individual61/r2-dtf/PCB/r2dtf dev board rev 1/Screenshot 2024-01-02 231258.png

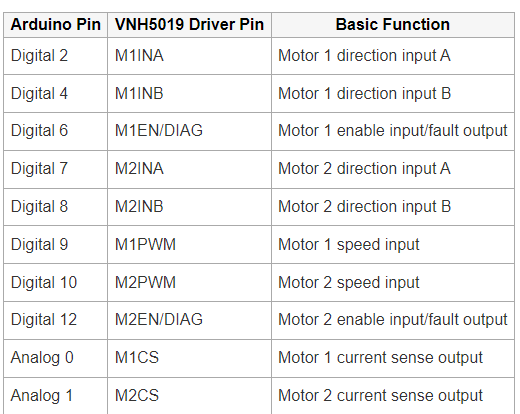
PCB/r2dtf dev board rev 1/Screenshot 2024-01-02 231258.png
