individual61/r2-dtf/Mechanicals/Sources for models/MPU 6050 IMU.SLDASM

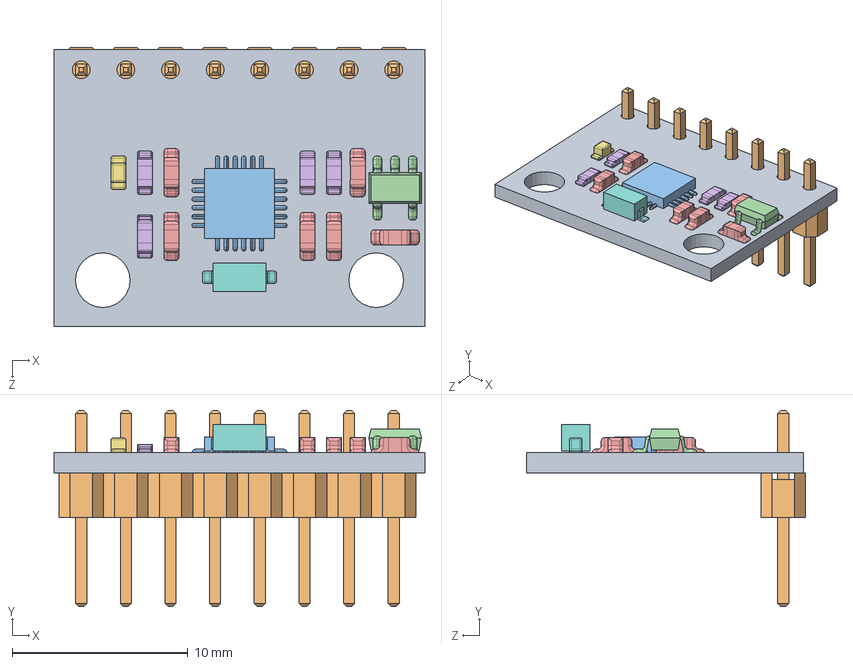
[picture p5: CAD file, 2018-06-27]
Mechanicals/Sources for models/MPU 6050 IMU.SLDASM
21.1 x 11.2 x 15.9 mm
Base
pin header x 8
sensor chip
S2NH chip
Resistor small x 6
Resistor small black x 4
Small LED
Resistor black
