individual61/r2-dtf/Mechanicals/Motor-bracket-wheel.SLDASM

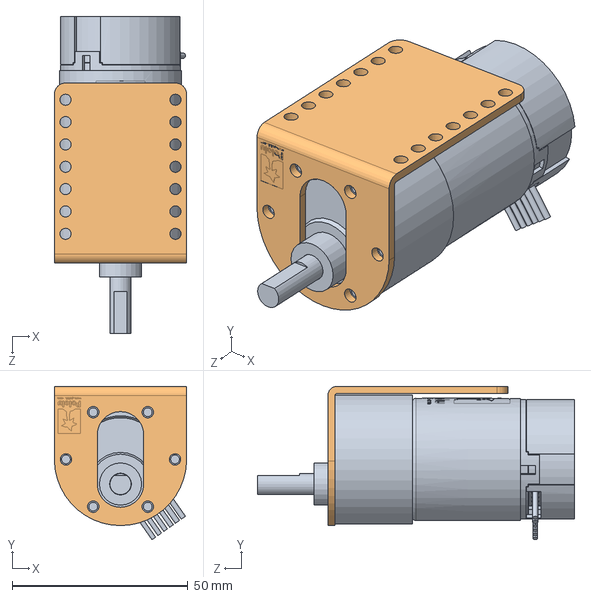
[picture p6: CAD file, 2025-01-21]
Mechanicals/Motor-bracket-wheel.SLDASM
37.6 x 43.6 x 90.1 mm
37d-gearmotor-19-30-encoder
pololu-stamped-aluminum-l-bracket-for-37d-mm-metal-gearmotors
