individual61/r2-dtf/Mechanicals/gy-521/User Library-GY-521.SLDASM

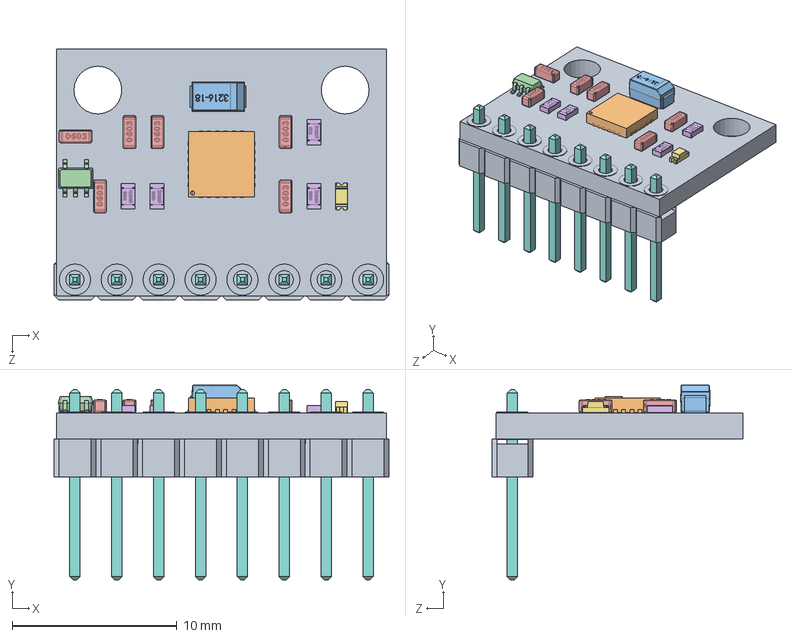
[picture p7: CAD file, 2024-02-24]
Mechanicals/gy-521/User Library-GY-521.SLDASM
20.3 x 11.8 x 15.2 mm
User Library-GY-521_placa
User Library-GY-521_User Library-mpu-6050_qfn-24
User Library-GY-521_User Library-CAP_TANT_3216-18_A_case-1
User Library-GY-521_User Library-sot353
User Library-GY-521_User Library-0603(1608M) Cap x 6
User Library-GY-521_User Library-RESC1608X05N x 4
User Library-GY-521_User Library-LED SMD0603
User Library-GY-521_User Library-Header_Male_8Pin_PinArray
User Library-GY-521_User Library-Header_Male_8Pin_BodyArray
