individual61/r2-dtf/Mechanicals/R2-DTF main assembly.SLDASM

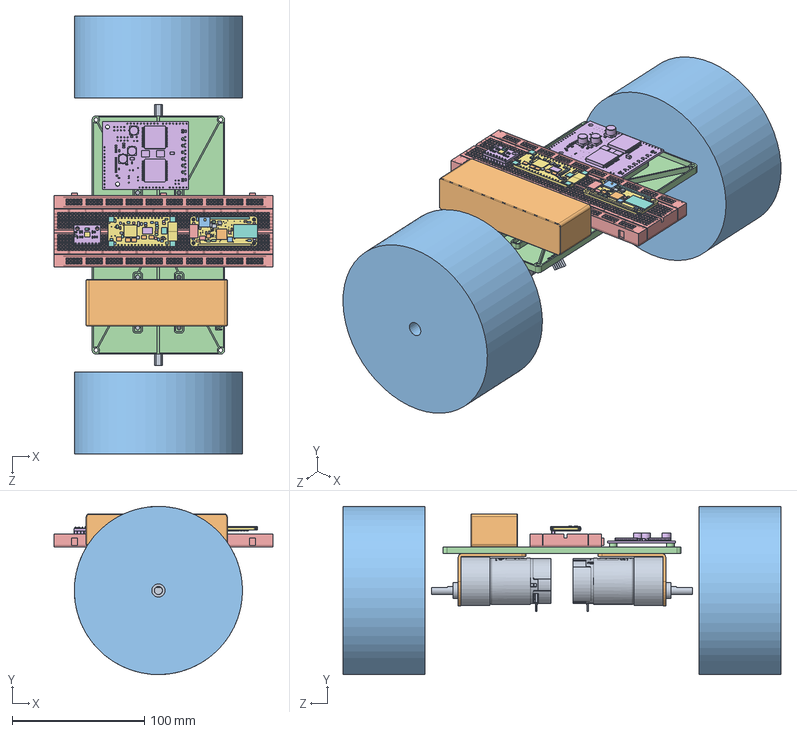
[picture p8: CAD file, 2018-06-27]
Mechanicals/R2-DTF main assembly.SLDASM
165.0 x 126.9 x 330.7 mm
37d-gearmotor-19-30-encoder x 2
pololu-stamped-aluminum-l-bracket-for-37d-mm-metal-gearmotors x 2
bigass wheel x 2
base REV A
BREADBOARD 60 ROW color
pololu-dual-vnh5019-motor-driver-shield
adafruit feather zero ble rev a
Capacitor 0603 x 5
Capacitor 0805 x 5
CHIPLED_0805_NOOUTLINE_ORANGE
SOD 123 x 3
CHIPLED_0805_NOOUTLINE_RED x 3
CHIPLED_0805_NOOUTLINE_BLUE
1X16_ROUND_JP1_1X16_ROUND
1X12_ROUND_JP3_1X12_ROUND
0603NO_100K x 3
0603NO_1K
0603NO_2_2K x 3
0603NO_10K_
KMR2_SPST_TACTKMR2
TESTPOINT_ROUND_1_5MM_TP1_TESTPOINT_ROUND_1_5MM
TESTPOINT_ROUND_1_5MM_TP2_TESTPOINT_ROUND_1_5MM
PAD1_5X2_0_SWCLK
PAD1_5X2_0_SWDIO x 2
TQFN48_7MM_ATSAMD21G18_QFN
ADAFRUIT_3_5MM_U_7_ADAFRUIT_3_5MM
FEATHERLOGO_U_9_FEATHERLOGO
PCBFEATREV040_U_25_PCBFEATREV040
BLUEFRUITLOGO_100MM_U_26_BLUEFRUITLOGO_100MM
FIDUCIAL_1MM_FIDUCIAL__ x 4
BLE_MODULE_RAYTAC_MDBT40_MBT40
SOT235_AP21123_3
SOT235_MCP73831T2ACI_OT
JSTPH2_JSTPH x 2
XTAL3215_32_768
4UCONN_20329_V2_MICROUSB
User Library-GY-521_placa
User Library-GY-521_User Library-mpu-6050_qfn-24
User Library-GY-521_User Library-CAP_TANT_3216-18_A_case-1
User Library-GY-521_User Library-sot353
User Library-GY-521_User Library-0603(1608M) Cap x 6
User Library-GY-521_User Library-RESC1608X05N x 4
User Library-GY-521_User Library-LED SMD0603
User Library-GY-521_User Library-Header_Male_8Pin_PinArray
User Library-GY-521_User Library-Header_Male_8Pin_BodyArray
adafruit ezsfx with amp
0805_10MGAP_10UF x 3
0805NO_1UF x 2
0805NO_0_1_F x 3
0805NO_4_7NF x 2
0805NO_1_F x 2
SOD323_1N4148
_0805MP_FERRITE x 2
TERMBLOCK_1X23_5MM_3_5MM x 2
CHIPLED_0805_NOOUTLINE_GREEN
0805NO_1M
RESPACK_4X0603_100K x 5
0805NO_470 x 4
0805NO_100K x 2
SOLDERJUMPER_ARROW_NOPASTE_SJ1_SOLDERJUMPER_ARROW_NOPASTE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
