individual61/r2-dtf/Mechanicals/gy-521/User Library-GY-521_User Library-mpu-6050_qfn-24.SLDPRT

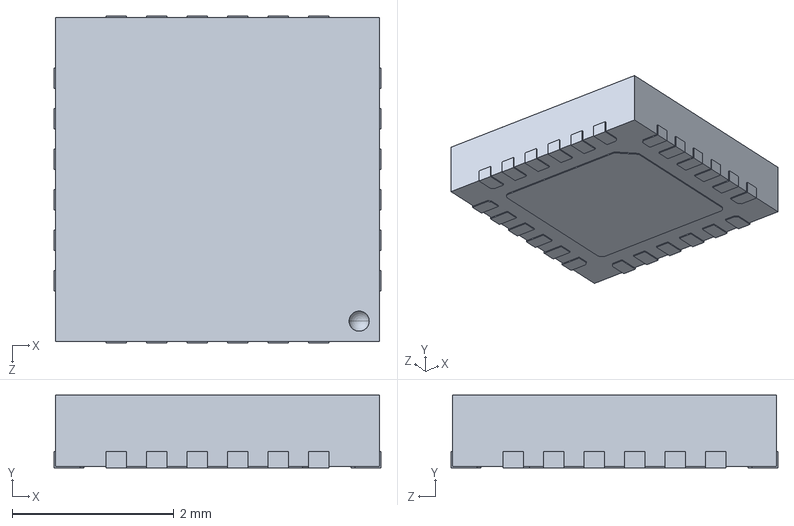
[picture p9: CAD file, 2024-02-24]
Mechanicals/gy-521/User Library-GY-521_User Library-mpu-6050_qfn-24.SLDPRT
4.04 x 0.9 x 4.04 mm
