individual61/r2-dtf/Mechanicals/Sources for models/BREADBOARD 60ROW/BREADBOARD 60 ROW.SLDPRT

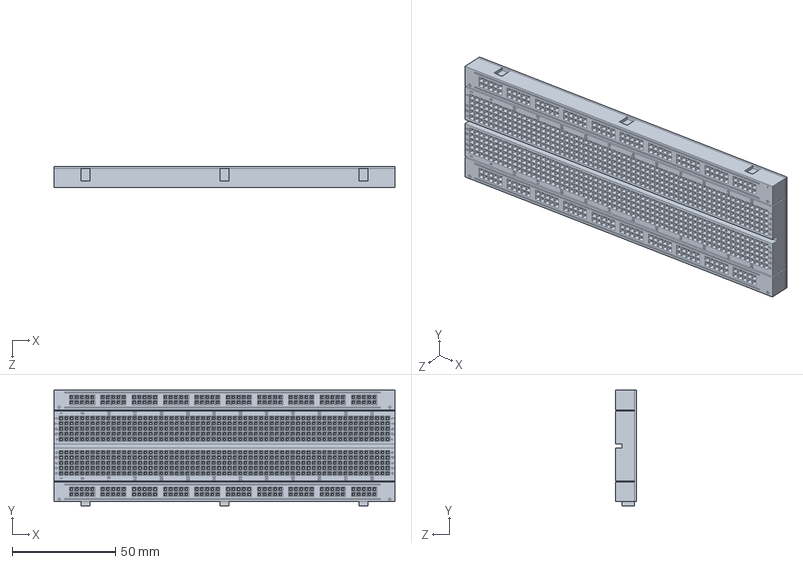
[picture p10: CAD file, 2018-06-27]
Mechanicals/Sources for models/BREADBOARD 60ROW/BREADBOARD 60 ROW.SLDPRT
165.0 x 56.0 x 10.0 mm
