individual61/r2-dtf/Mechanicals/Test Stand Rev 1.STEP

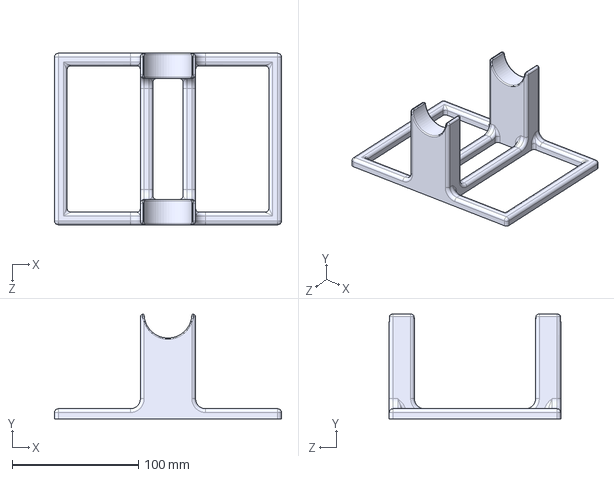
[picture p11: CAD file, 2025-01-21]
Mechanicals/Test Stand Rev 1.STEP
180.0 x 83.0 x 136.0 mm
