individual61/r2-dtf/Mechanicals/gy-521/User Library-GY-521_User Library-CAP_TANT_3216-18_A_case-1.SLDPRT

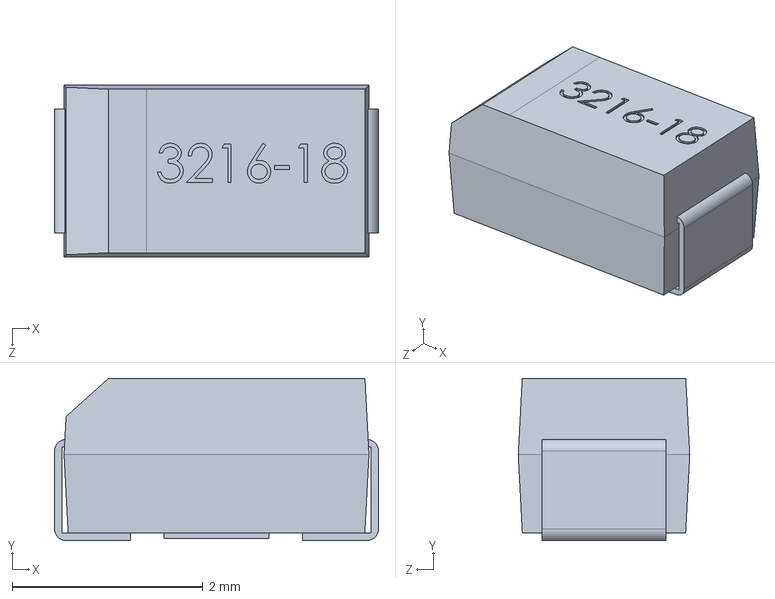
[picture p12: CAD file, 2024-02-24]
Mechanicals/gy-521/User Library-GY-521_User Library-CAP_TANT_3216-18_A_case-1.SLDPRT
3.40 x 1.70 x 1.80 mm
