individual61/r2-dtf/Mechanicals/Sources for models/37d-gearmotor-19-30-encoder.step

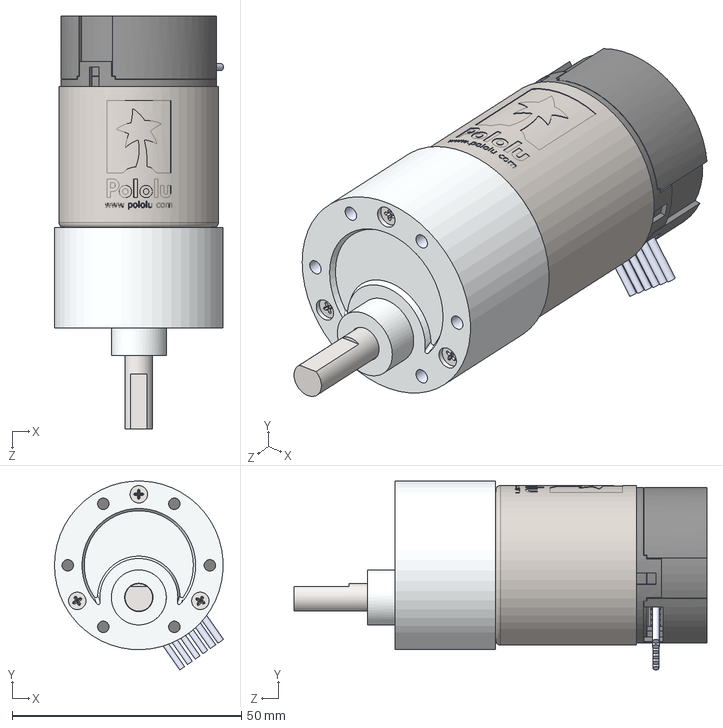
[picture p13: CAD file, 2018-06-27]
Mechanicals/Sources for models/37d-gearmotor-19-30-encoder.step
36.9 x 41.2 x 90.1 mm
