individual61/r2-dtf/Mechanicals/Sources for models/pololu-universal-aluminum-mounting-hub-for-6mm-shaft-4-40-holes.step

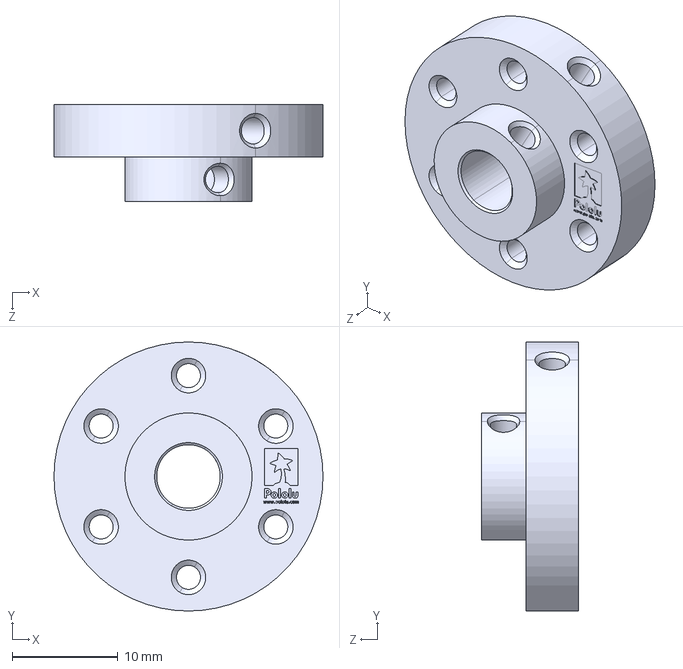
[picture p14: CAD file, 2018-06-27]
Mechanicals/Sources for models/pololu-universal-aluminum-mounting-hub-for-6mm-shaft-4-40-holes.step
25.4 x 25.4 x 9.20 mm
