individual61/r2-dtf/Mechanicals/Frame Rev 1.STEP

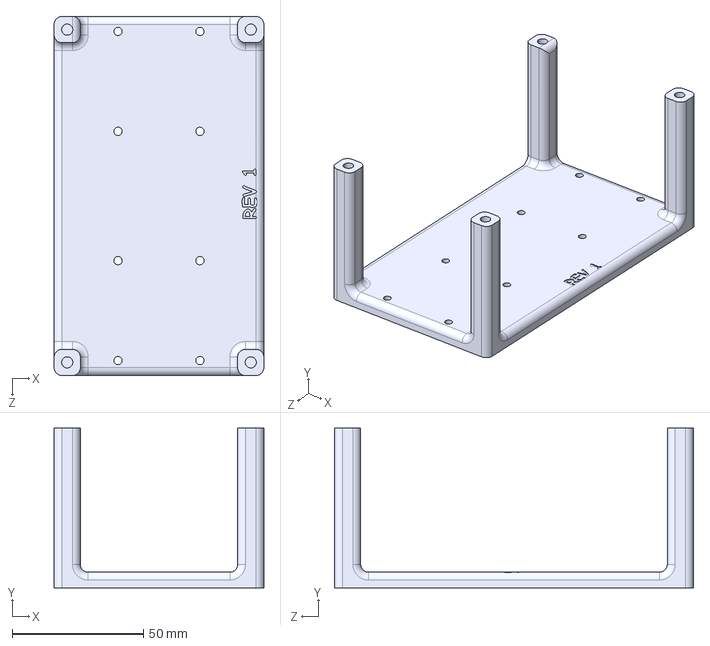
[picture p15: CAD file, 2024-02-27]
Mechanicals/Frame Rev 1.STEP
80.0 x 61.0 x 136.9 mm
