individual61/r2-dtf/Mechanicals/Sources for models/pololu-stamped-aluminum-l-bracket-for-37d-mm-metal-gearmotors.step

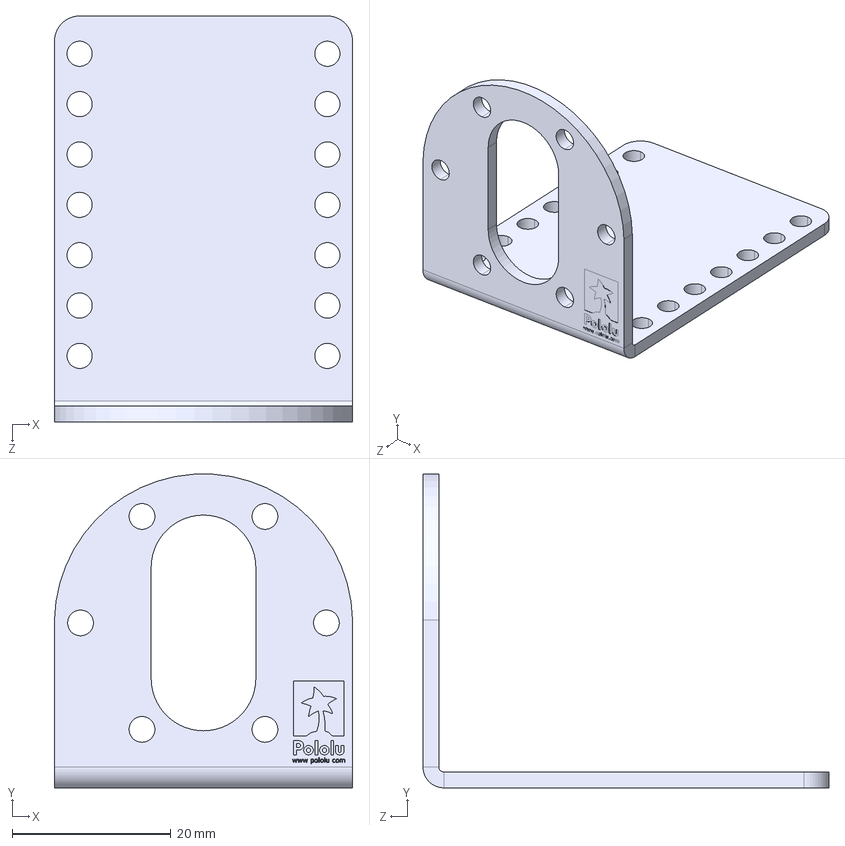
[picture p16: CAD file, 2018-06-27]
Mechanicals/Sources for models/pololu-stamped-aluminum-l-bracket-for-37d-mm-metal-gearmotors.step
37.6 x 39.6 x 51.2 mm
