individual61/r2-dtf/Mechanicals/gy-521/User Library-GY-521_User Library-RESC1608X05N.SLDPRT

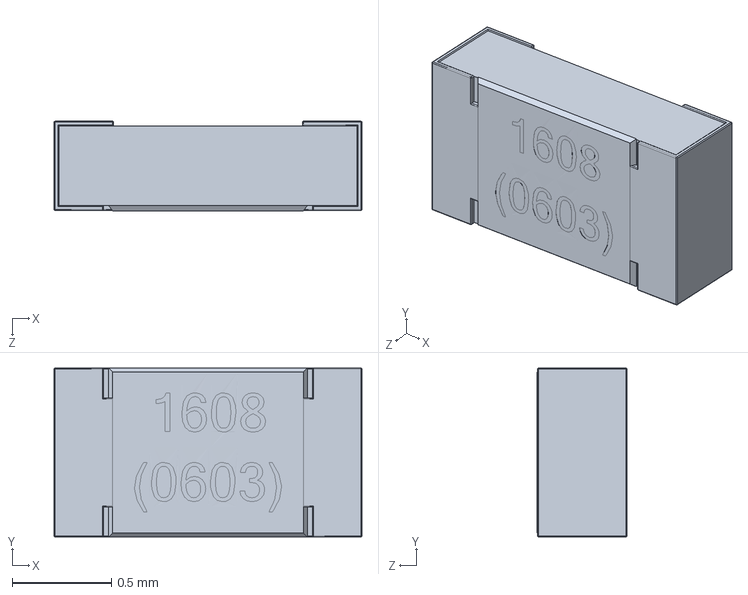
[picture p17: CAD file, 2024-02-24]
Mechanicals/gy-521/User Library-GY-521_User Library-RESC1608X05N.SLDPRT
1.55 x 0.85 x 0.451 mm
