individual61/r2-dtf/Mechanicals/M3 x 16 - actually 15.7.SLDPRT

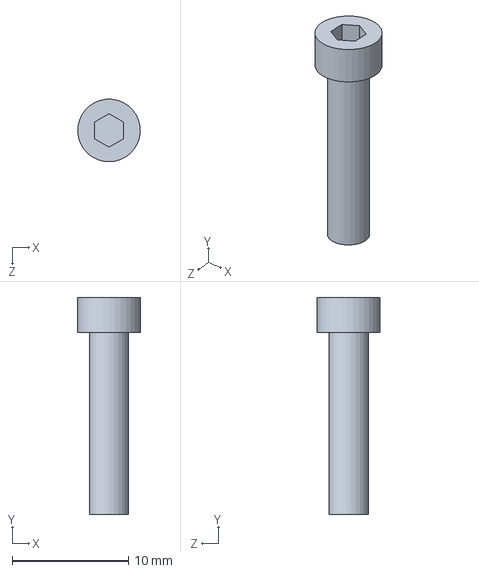
[picture p18: CAD file, 2024-02-27]
Mechanicals/M3 x 16 - actually 15.7.SLDPRT
5.39 x 18.7 x 5.39 mm
