individual61/r2-dtf/Mechanicals/gy-521/User Library-GY-521_User Library-0603(1608M) Cap.SLDPRT

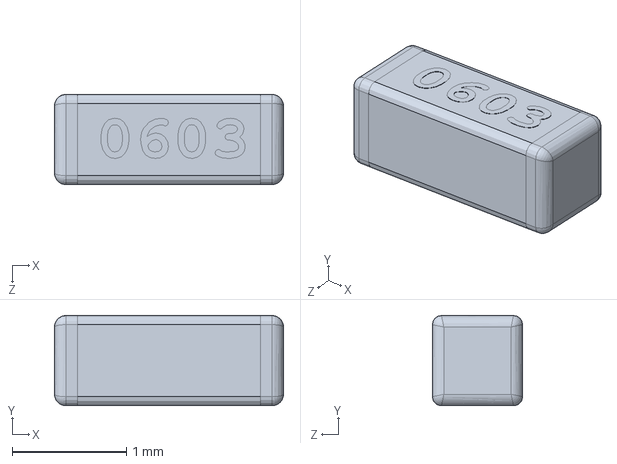
[picture p19: CAD file, 2024-02-24]
Mechanicals/gy-521/User Library-GY-521_User Library-0603(1608M) Cap.SLDPRT
2.00 x 0.79 x 0.787 mm
