individual61/r2-dtf/Mechanicals/M3 x 8 - actually 7.8.SLDPRT

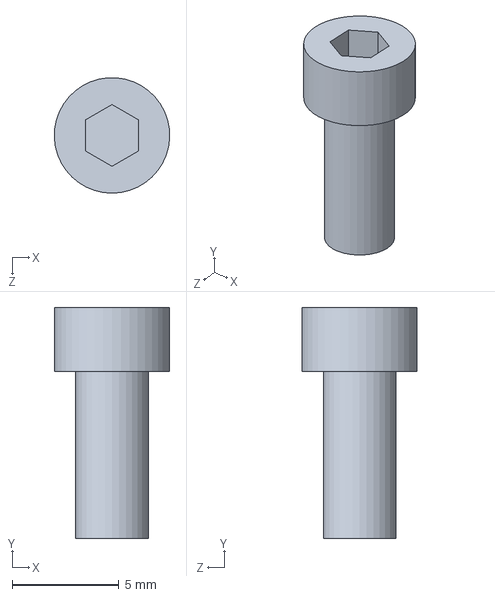
[picture p20: CAD file, 2024-02-27]
Mechanicals/M3 x 8 - actually 7.8.SLDPRT
5.40 x 10.8 x 5.39 mm
