individual61/r2-dtf/Mechanicals/Bumper Rev 1.STEP

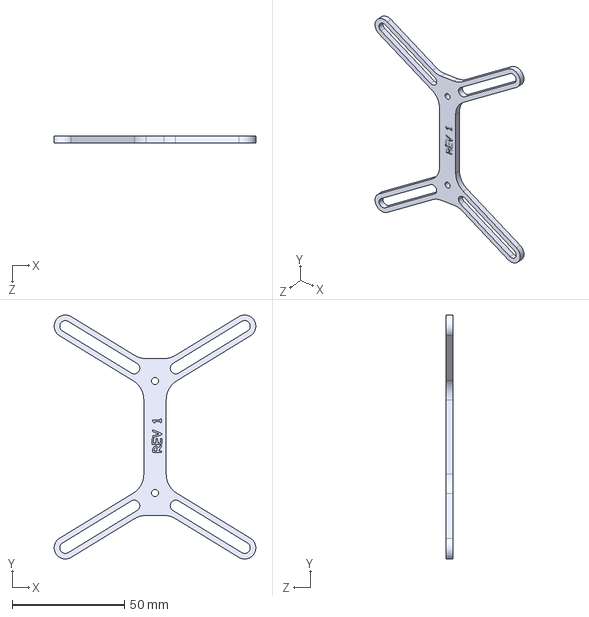
[picture p21: CAD file, 2024-02-27]
Mechanicals/Bumper Rev 1.STEP
90.0 x 108.9 x 3.00 mm
