individual61/r2-dtf/Mechanicals/gy-521/User Library-GY-521_User Library-LED SMD0603.SLDPRT

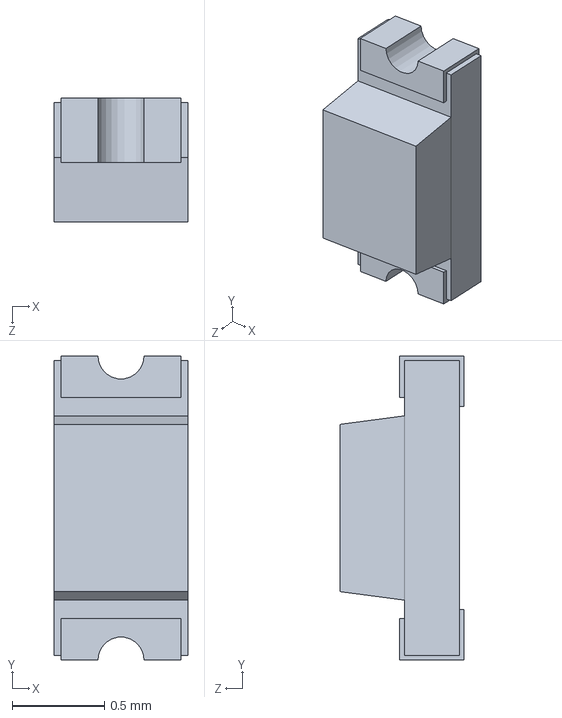
[picture p22: CAD file, 2024-02-24]
Mechanicals/gy-521/User Library-GY-521_User Library-LED SMD0603.SLDPRT
0.725 x 1.65 x 0.675 mm
