individual61/r2-dtf/Mechanicals/Frame top Rev 1.STEP

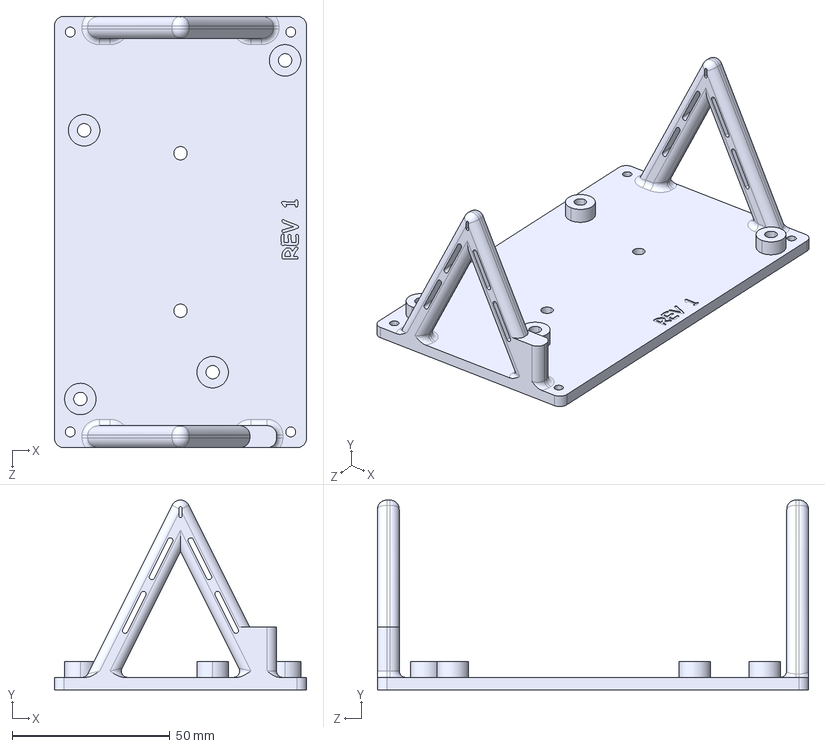
[picture p23: CAD file, 2024-02-27]
Mechanicals/Frame top Rev 1.STEP
80.0 x 60.3 x 136.9 mm
