individual61/r2-dtf/Mechanicals/gy-521/User Library-GY-521_User Library-sot353.SLDPRT

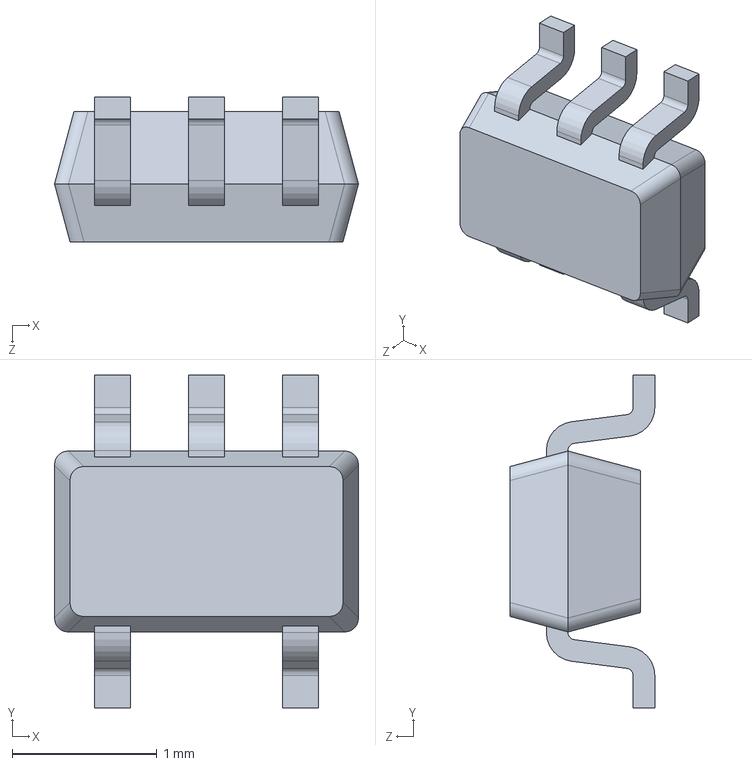
[picture p24: CAD file, 2024-02-24]
Mechanicals/gy-521/User Library-GY-521_User Library-sot353.SLDPRT
2.10 x 2.30 x 1.00 mm
