individual61/r2-dtf/Mechanicals/gy-521/User Library-GY-521_placa.SLDPRT

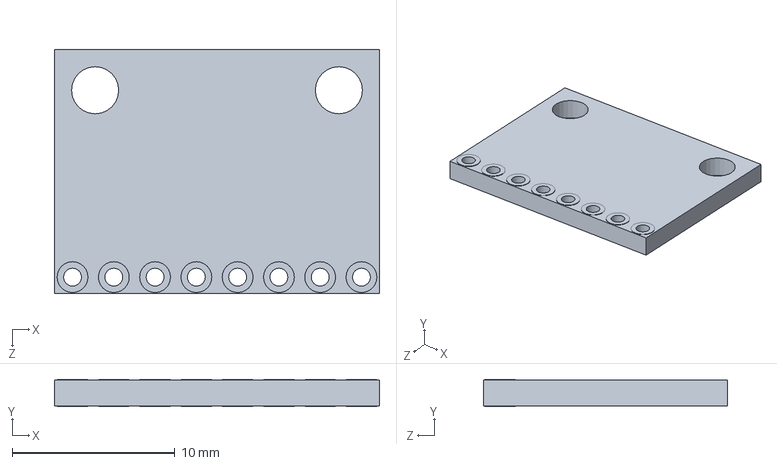
[picture p25: CAD file, 2024-02-24]
Mechanicals/gy-521/User Library-GY-521_placa.SLDPRT
20.0 x 1.67 x 15.0 mm
