individual61/r2-dtf/Mechanicals/M3 x 6.SLDPRT

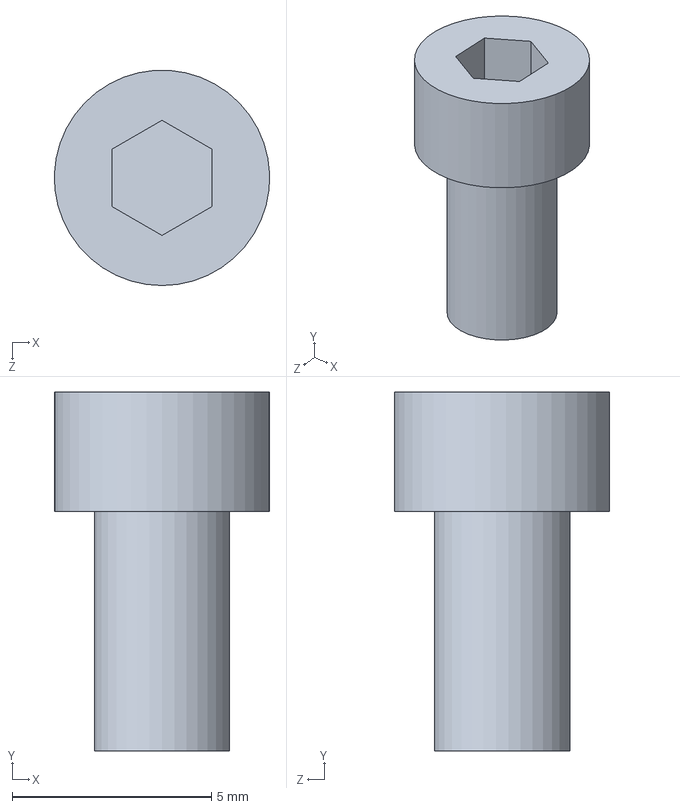
[picture p26: CAD file, 2024-02-27]
Mechanicals/M3 x 6.SLDPRT
5.40 x 9.00 x 5.39 mm
