individual61/r2-dtf/Mechanicals/pololu-wheel-90x10mm-yellow.step

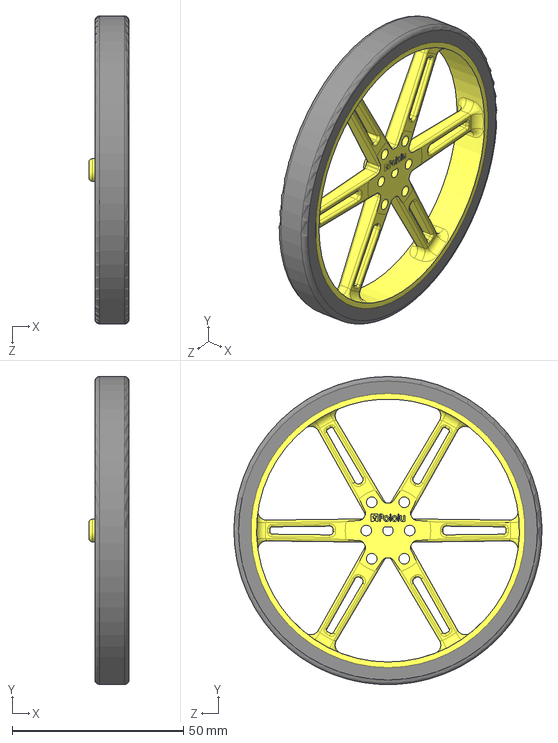
[picture p27: CAD file, 2024-02-24]
Mechanicals/pololu-wheel-90x10mm-yellow.step
11.8 x 90.0 x 90.0 mm
