individual61/r2-dtf/Mechanicals/base REV A.SLDPRT

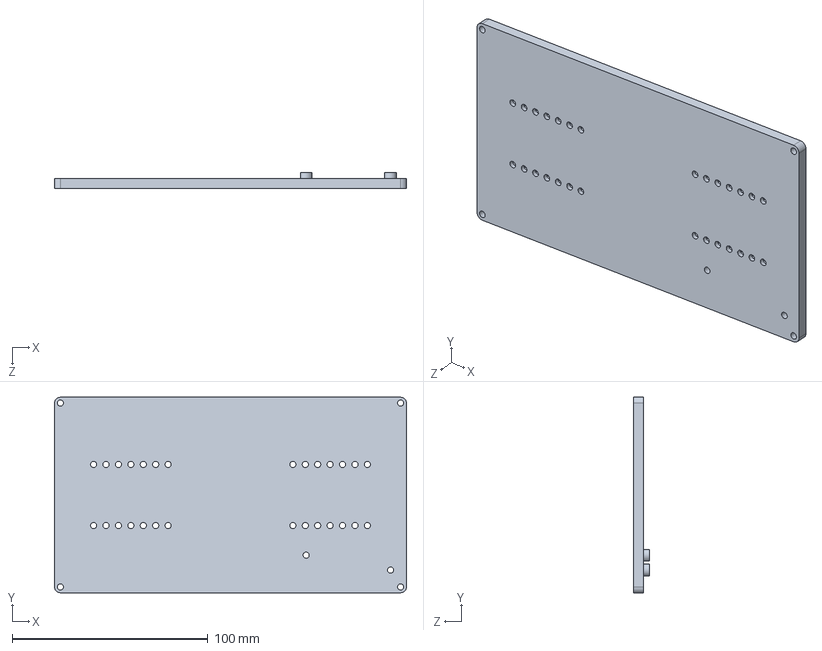
[picture p28: CAD file, 2024-02-24]
Mechanicals/base REV A.SLDPRT
180.0 x 100.0 x 8.00 mm
