individual61/r2-dtf/Mechanicals/pololu-dual-vnh5019-motor-driver-shield.SLDPRT

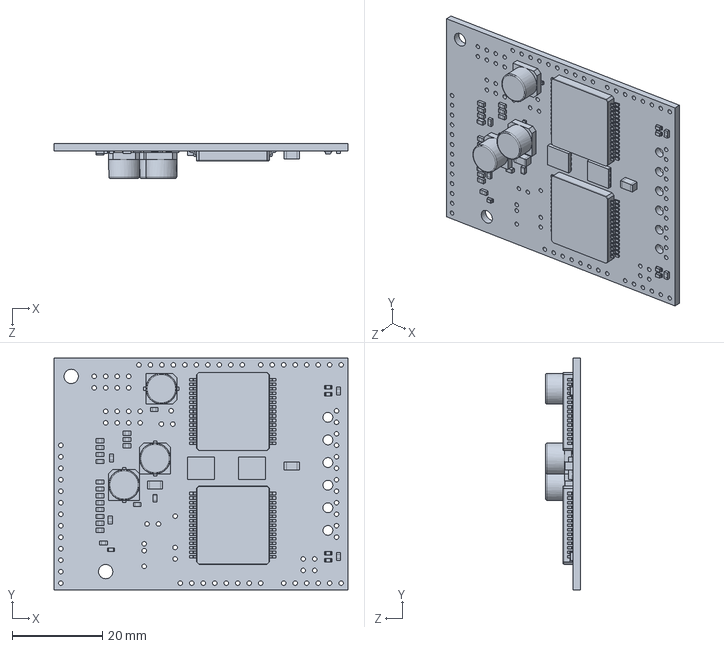
[picture p29: CAD file, 2024-02-24]
Mechanicals/pololu-dual-vnh5019-motor-driver-shield.SLDPRT
65.0 x 51.3 x 7.67 mm
