individual61/r2-dtf/Mechanicals/lipo 3s battery.SLDPRT

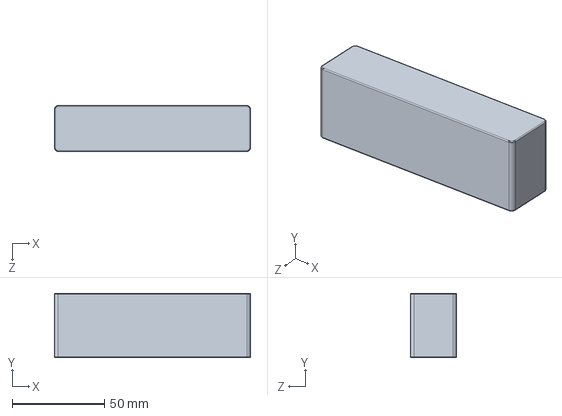
[picture p30: CAD file, 2024-02-24]
Mechanicals/lipo 3s battery.SLDPRT
106.5 x 35.0 x 25.0 mm
