individual61/r2-dtf/Mechanicals/bigass wheel.SLDPRT

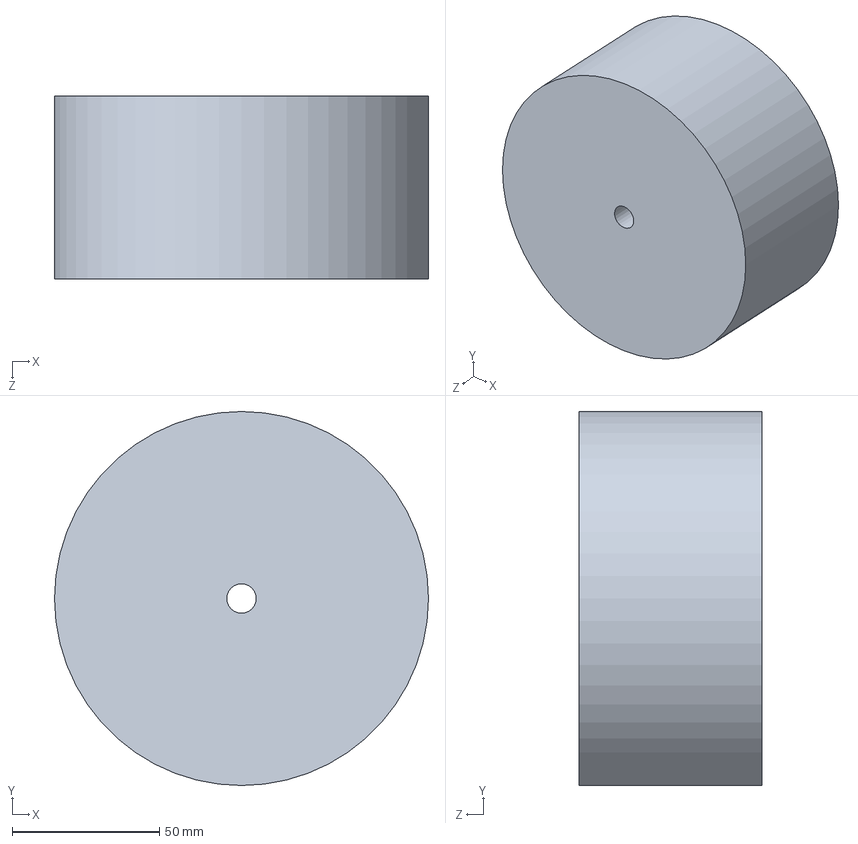
[picture p31: CAD file, 2024-02-24]
Mechanicals/bigass wheel.SLDPRT
127.0 x 127.0 x 62.0 mm
