individual61/r2-dtf/Mechanicals/speaker.SLDPRT

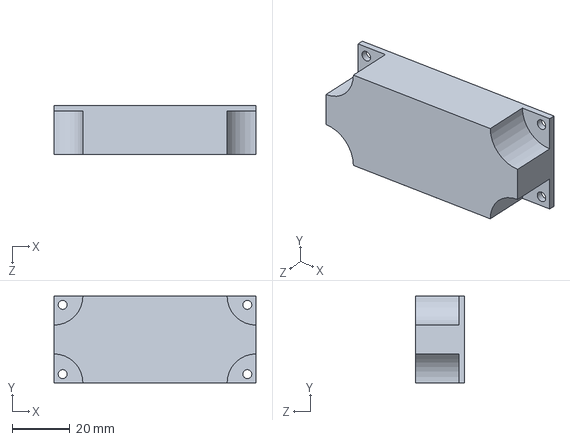
[picture p32: CAD file, 2018-06-27]
Mechanicals/speaker.SLDPRT
70.0 x 30.0 x 17.0 mm
