individual61/r2-dtf/Mechanicals/gy-521/User Library-GY-521_User Library-Header_Male_8Pin.sldasm

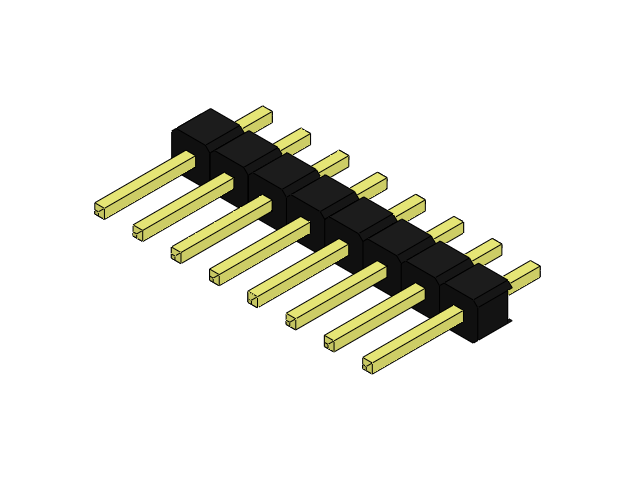
[picture p33: CAD file, 2024-02-24]
Mechanicals/gy-521/User Library-GY-521_User Library-Header_Male_8Pin.sldasm
User Library-GY-521_User Library-Header_Male_8Pin_PinArray
User Library-GY-521_User Library-Header_Male_8Pin_BodyArray
