individual61/r2-dtf/(list of files, cad)

Other CAD files:
Mechanicals/adafruit ezsfx with amp.SLDASM
Mechanicals/adafruit feather zero ble rev a.SLDASM
Mechanicals/gy-521/User Library-GY-521_User Library-Header_Male_8Pin_PinArray.sldprt
Mechanicals/M3 x 12 - actually 11.6.SLDPRT
Mechanicals/gy-521/User Library-GY-521_User Library-Header_Male_8Pin_BodyArray.sldprt
Mechanicals/37d-gearmotor-19-30-encoder.SLDPRT
Mechanicals/pololu-wheel-90x10mm-black.step
Mechanicals/pololu-stamped-aluminum-l-bracket-for-37d-mm-metal-gearmotors.SLDPRT
Mechanicals/pololu-wheel-90x10mm-white.step
Mechanicals/pololu-wheel-90x10mm-blue.step
Mechanicals/pololu-universal-aluminum-mounting-hub-for-6mm-shaft-4-40-holes.SLDPRT
Mechanicals/BREADBOARD 60 ROW color.SLDPRT
Mechanicals/pololu-wheel-90x10mm-red.step
Mechanicals/Bumper Rev 1.SLDPRT
Mechanicals/Frame Rev 1.3mf
Mechanicals/Frame Rev 1.SLDPRT
Mechanicals/Frame top Rev 1.SLDPRT
Mechanicals/M3 Nut.SLDPRT
Mechanicals/M3 Washer.SLDPRT
Mechanicals/Test Stand Rev 1.SLDPRT
Mechanicals/base REV A.STL
Mechanicals/base.SLDPRT
Mechanicals/pololu-wheel-90x10mm-red.SLDPRT
