individual61/r2-dtf/PCB/r2dtf dev board rev 1/r2dtf dev board rev 1.pdf

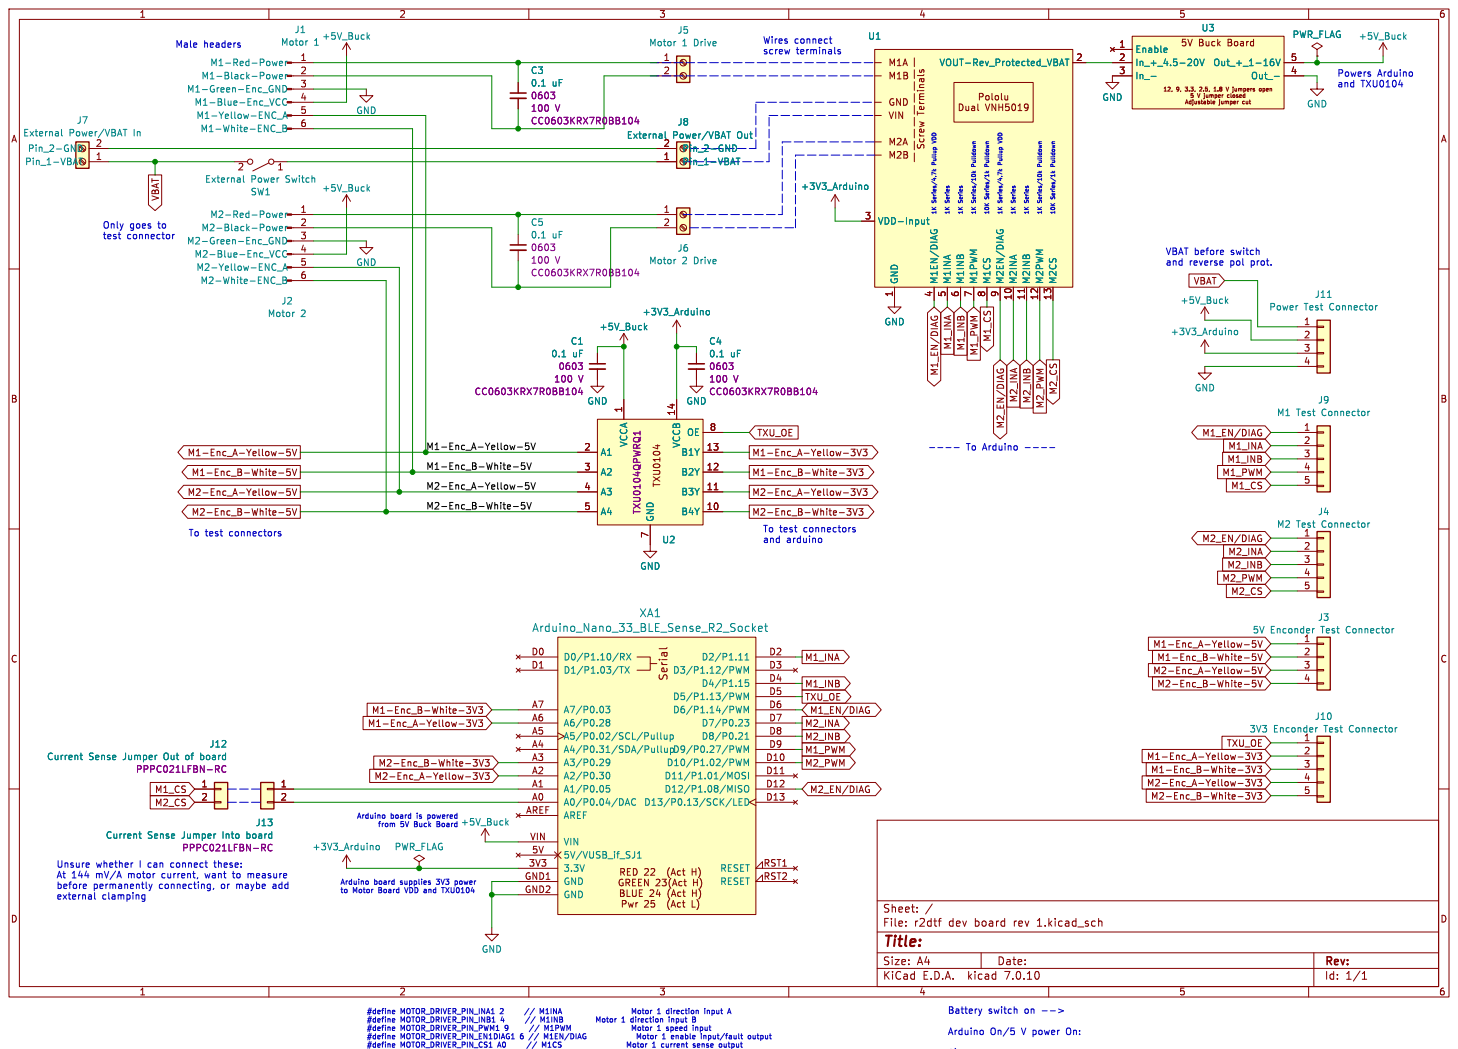
[picture p34: page 1]

9 U1 +5V_Buck 1
J6 Motor 2 Drive GND GND

1 M2INA 10 M2INB 11 M2PWM 12 M2CS 13 VOUT-Rev_Protected_VBAT 2 VDD-Input 3 M1EN/DIAG

and TXU0104 VBAT before switch

and reverse pol prot.
VBAT

J12 Current Sense Jumper Out of board PPPC021LFBN-RC

J13 Current Sense Jumper Into board PPPC021LFBN-RC

to Motor Board VDD and TXU0104 Female headers 2- pos: (2) Current Sense Jumper

Battery switch on --> Arduino On/5 V power On: 1) OE of TXU0104 is disabled Motor INXA/B are both low so CS output is 0. 2) OE is enabled, passing Hall sensor signals through
