individual61/r2-dtf/PCB/r2dtf dev board rev 1/Layout Rev 1 for print.pdf

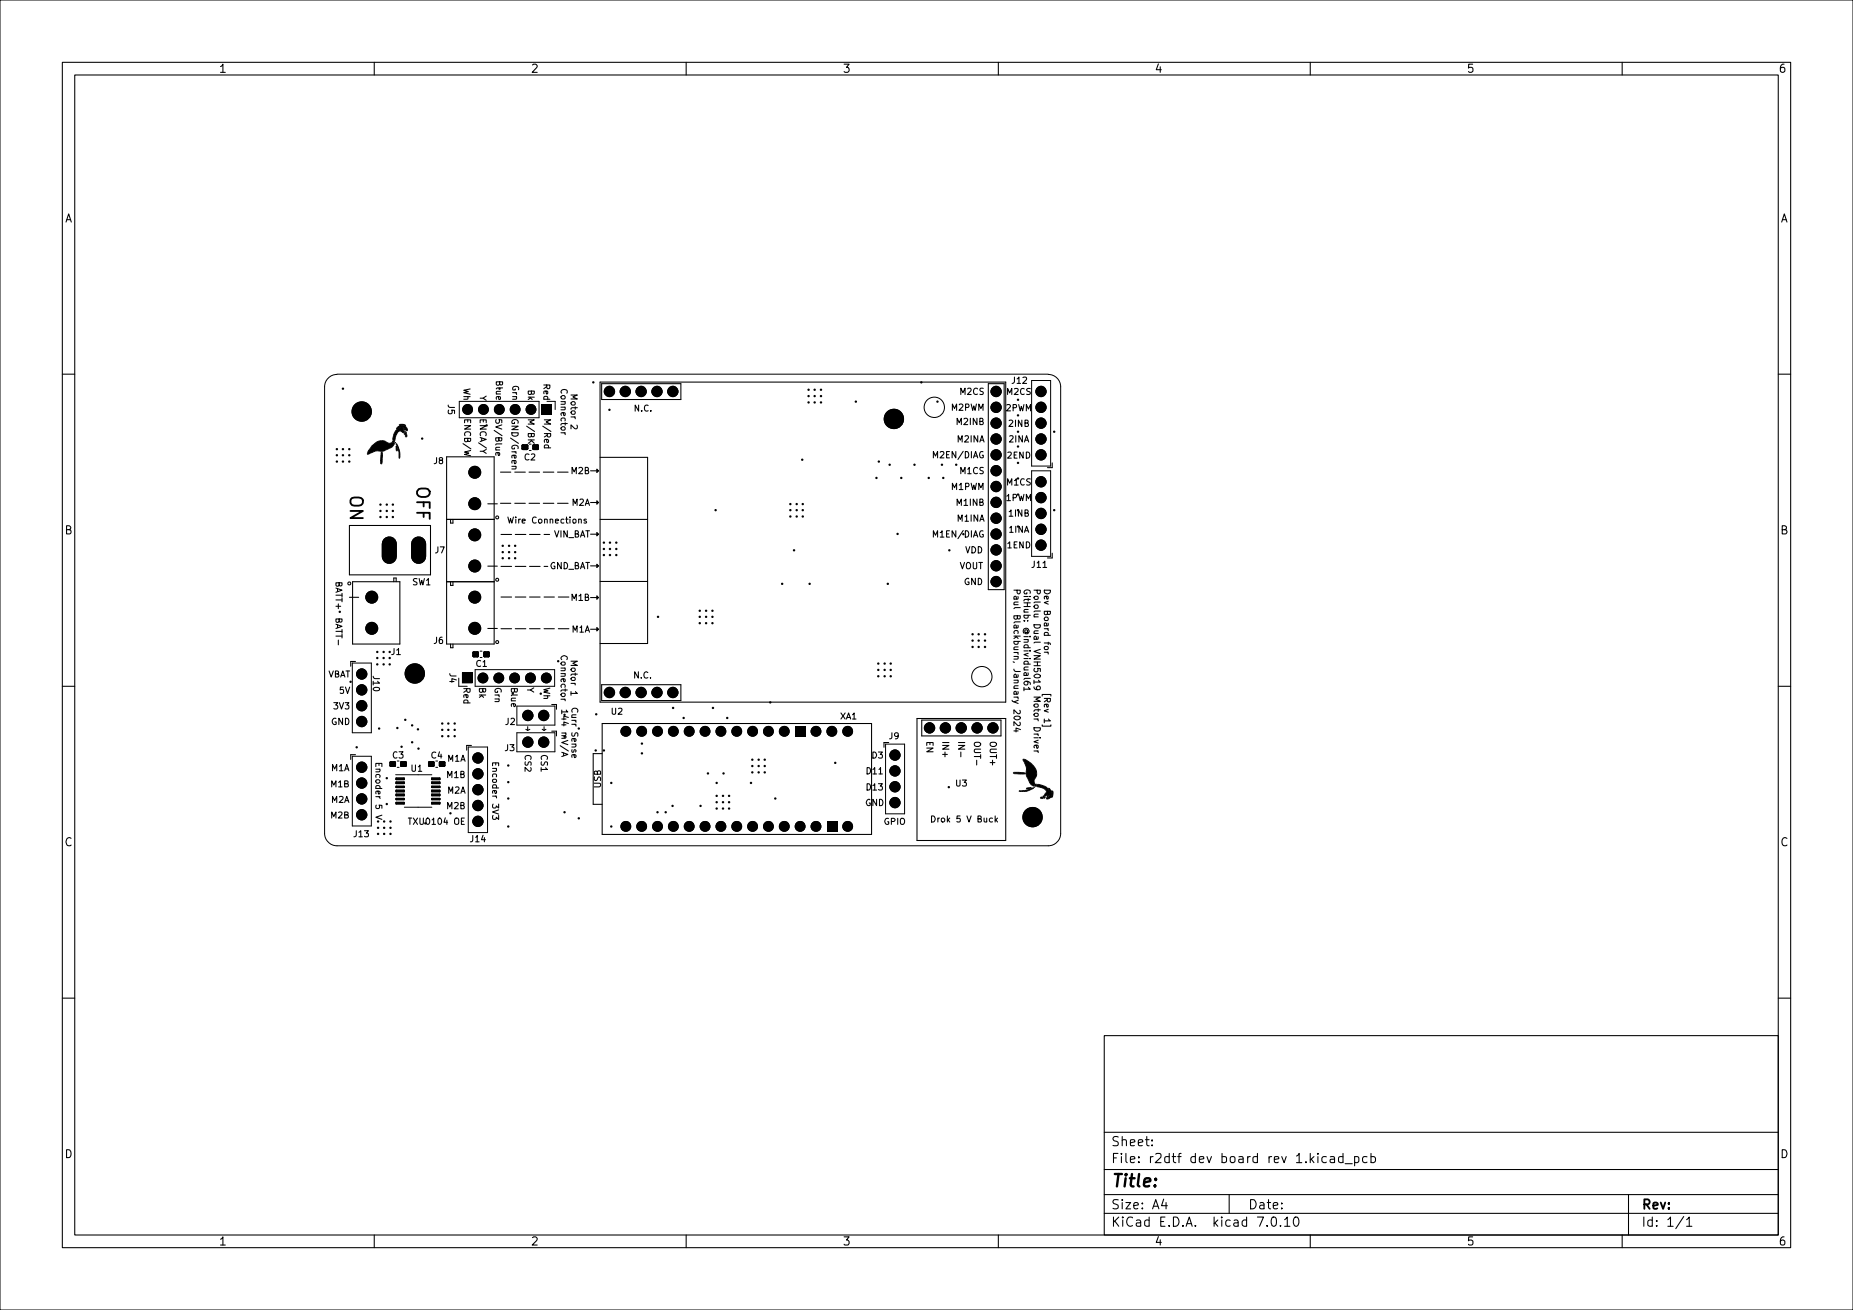
[picture p35: page 1]
