individual61/r2-dtf/PCB/r2dtf dev board rev 1/r2dtf dev board rev 1.kicad_pcb

## KiCad design PCB/r2dtf dev board rev 1/r2dtf dev board rev 1.kicad_pcb (2024-01-19)

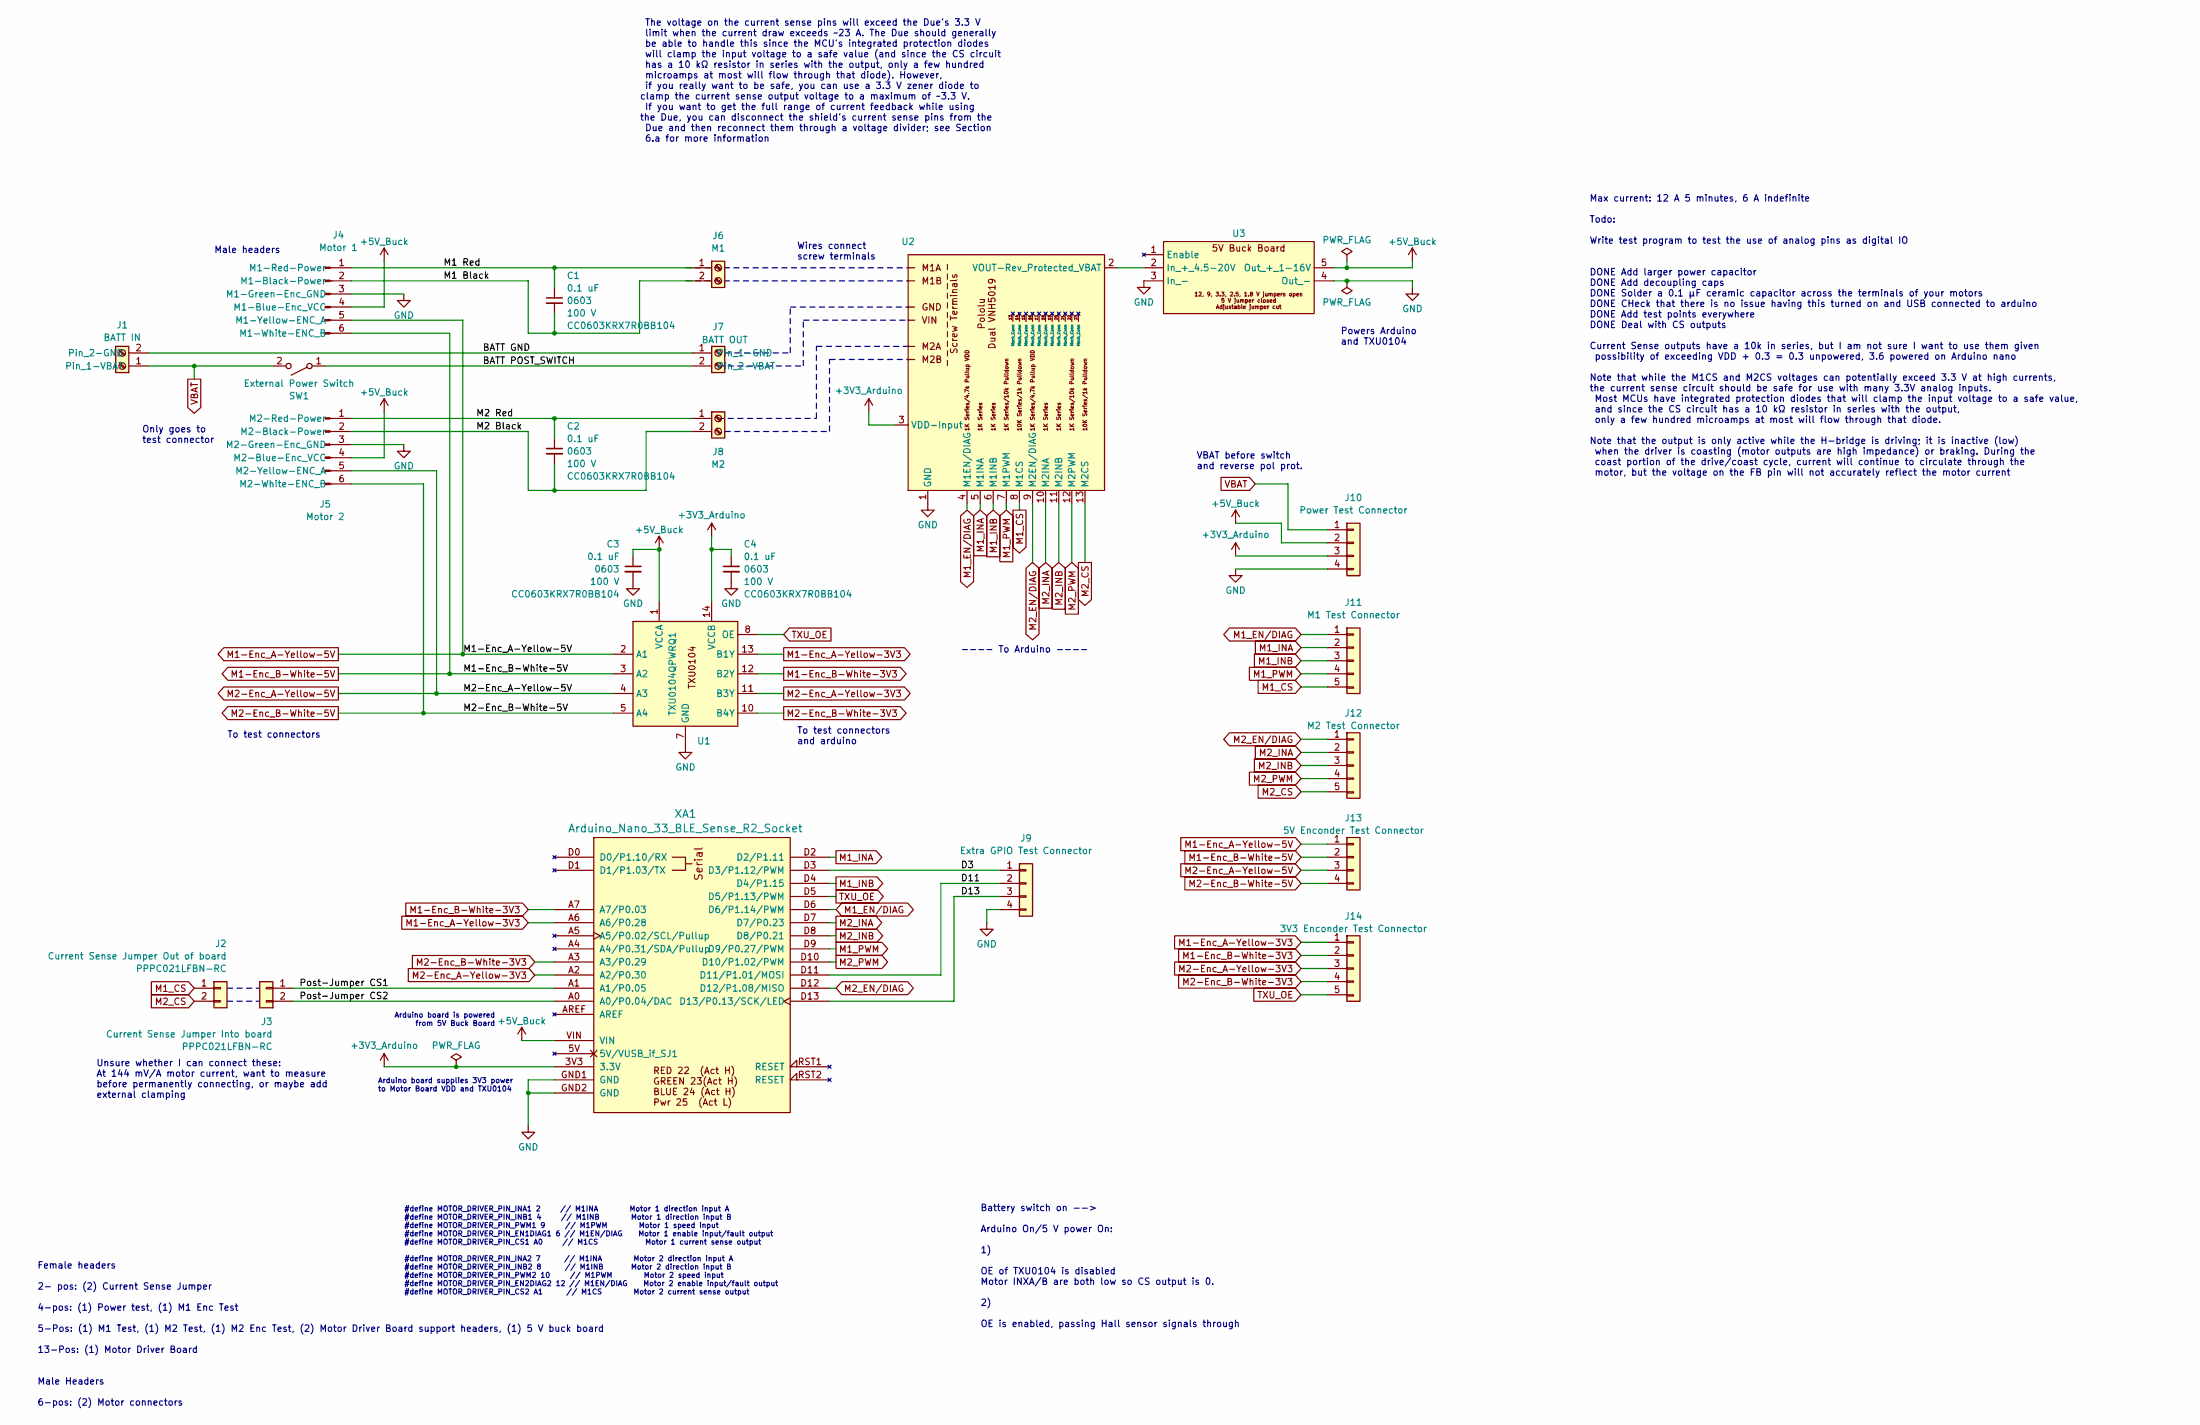
[picture p36: schematic r2dtf dev board rev 1.kicad_sch]

Parts:
C1, C2, C3, C4: 0.1 uF; C_0603_1608Metric_Pad1.08x0.95mm_HandSolder; Voltage Rating 100 V; MPN CC0603KRX7R0BB104; Digi-Key_PN 311-1523-1-ND
J1: BATT IN; Screw Terminal 2P 5 mm, Degson DG301-5.0-02P
J2: Current Sense Jumper Out of board; Sullins Header Female TH 2 x 1 PPPC021LFBN-RC; MPN PPPC021LFBN-RC
J3: Current Sense Jumper Into board; Sullins Header Female TH 2 x 1 PPPC021LFBN-RC; MPN PPPC021LFBN-RC
J4: Motor 1; PinHeader_1x06_P2.54mm_Vertical
J5: Motor 2; PinHeader_1x06_P2.54mm_Vertical
J6: M1; Screw Terminal 2P 5 mm, Degson DG301-5.0-02P
J7: BATT OUT; Screw Terminal 2P 5 mm, Degson DG301-5.0-02P
J8: M2; Screw Terminal 2P 5 mm, Degson DG301-5.0-02P
J9: Extra GPIO Test Connector; Sullins Header Female TH 4 x 1 PPPC041LFBN-RC; MPN PPPC041LFBN-RC
J10: Power Test Connector; Sullins Header Female TH 4 x 1 PPPC041LFBN-RC; MPN PPPC041LFBN-RC
J11: M1 Test Connector; Sullins Header Female TH 5 x 1 PPPC051LFBN-RC; MPN PPPC051LFBN-RC
J12: M2 Test Connector; Sullins Header Female TH 5 x 1 PPPC051LFBN-RC; MPN PPPC051LFBN-RC
J13: 5V Enconder Test Connector; Sullins Header Female TH 4 x 1 PPPC041LFBN-RC; MPN PPPC041LFBN-RC
J14: 3V3 Enconder Test Connector; Sullins Header Female TH 5 x 1 PPPC051LFBN-RC; MPN PPPC051LFBN-RC
SW1: External Power Switch; Daier MTS-101 Toggle Switch 6A 125 VAC
U1: TSSOP-14_4.4x5mm_P0.65mm; MPN TXU0104QPWRQ1
U2: Pololu Dual VNH5019 Motor Driver rev ash02b
U3: 12V to 5V Buck Converter; Drok 5 V Buck Converter
XA1: Arduino_Nano_33_BLE_Sense_R2_Socket; Arduino_Nano_Every_Socket

Connections:
+3V3: C4.1, J10.3, U1.14 (VCCB), U2.3 (VDD-Input), XA1.3V3 (3.3V)
+5V: C3.1, J4.4 (M1-Blue-Enc_VCC), J5.4 (M2-Blue-Enc_VCC), J10.2, U1.1 (VCCA), U3.5 (Out_+_1-16V), XA1.VIN
/BATT GND: J1.2 (Pin_2-GND), J7.1 (Pin_1-GND)
/BATT POST_SWITCH: J7.2 (Pin_2-VBAT), SW1.1 (A)
/D3: J9.1, XA1.D3 (D3/P1.12/PWM)
/D11: J9.2, XA1.D11 (D11/P1.01/MOSI)
/D13: J9.3, XA1.D13 (D13/P0.13/SCK/LED)
/M1 Black: C1.2, J4.2 (M1-Black-Power), J6.2
/M1 Red: C1.1, J4.1 (M1-Red-Power), J6.1
/M2 Black: C2.2, J5.2 (M2-Black-Power), J8.2
/M2 Red: C2.1, J5.1 (M2-Red-Power), J8.1
/Post-Jumper CS1: J3.1, XA1.A1 (A1/P0.05)
/Post-Jumper CS2: J3.2, XA1.A0 (A0/P0.04/DAC)
GND: C3.2, C4.2, J4.3 (M1-Green-Enc_GND), J5.3 (M2-Green-Enc_GND), J9.4, J10.4, U1.7 (GND), U2.1 (GND), U3.3 (In_-), U3.4 (Out_-), XA1.GND1 (GND), XA1.GND2 (GND)
M1-Enc_A-Yellow-3V3: J14.1, U1.13 (B1Y), XA1.A6 (A6/P0.28)
M1-Enc_A-Yellow-5V: J4.5 (M1-Yellow-ENC_A), J13.1, U1.2 (A1)
M1-Enc_B-White-3V3: J14.2, U1.12 (B2Y), XA1.A7 (A7/P0.03)
M1-Enc_B-White-5V: J4.6 (M1-White-ENC_B), J13.2, U1.3 (A2)
M1_CS: J2.1, J11.5, U2.8 (M1CS)
M1_EN/DIAG: J11.1, U2.4 (M1EN/DIAG), XA1.D6 (D6/P1.14/PWM)
M1_INA: J11.2, U2.5 (M1INA), XA1.D2 (D2/P1.11)
M1_INB: J11.3, U2.6 (M1INB), XA1.D4 (D4/P1.15)
M1_PWM: J11.4, U2.7 (M1PWM), XA1.D9 (D9/P0.27/PWM)
M2-Enc_A-Yellow-3V3: J14.3, U1.11 (B3Y), XA1.A2 (A2/P0.30)
M2-Enc_A-Yellow-5V: J5.5 (M2-Yellow-ENC_A), J13.3, U1.4 (A3)
M2-Enc_B-White-3V3: J14.4, U1.10 (B4Y), XA1.A3 (A3/P0.29)
M2-Enc_B-White-5V: J5.6 (M2-White-ENC_B), J13.4, U1.5 (A4)
M2_CS: J2.2, J12.5, U2.13 (M2CS)
M2_EN/DIAG: J12.1, U2.9 (M2EN/DIAG), XA1.D12 (D12/P1.08/MISO)
M2_INA: J12.2, U2.10 (M2INA), XA1.D7 (D7/P0.23)
M2_INB: J12.3, U2.11 (M2INB), XA1.D8 (D8/P0.21)
M2_PWM: J12.4, U2.12 (M2PWM), XA1.D10 (D10/P1.02/PWM)
unnamed: U2.2 (VOUT-Rev_Protected_VBAT), U3.2 (In_+_4.5-20V)
TXU_OE: J14.5, U1.8 (OE), XA1.D5 (D5/P1.13/PWM)
VBAT: J1.1 (Pin_1-VBAT), J10.1, SW1.2 (B)

Notes on the sheet:
---- To Arduino ----
To test connectors
The voltage on the current sense pins will exceed the Due's 3.3 V limit when the current draw exceeds ~23 A. The Due should generally be able to handle this since the MCU's integrated protection diodes will clamp the input voltage to a safe value (and since the CS circuit has a 10 kΩ resistor in se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
To test connectors and arduino
Arduino board supplies 3V3 power to Motor Board VDD and TXU0104
VBAT before switch and reverse pol prot.
Battery switch on --> Arduino On/5 V power On: 1) OE of TXU0104 is disabled Motor INXA/B are both low so CS output is 0. 2) OE is enabled, passing Hall sensor signals through
#define MOTOR_DRIVER_PIN_INA1 2 // M1INA Motor 1 direction input A #define MOTOR_DRIVER_PIN_INB1 4 // M1INB Motor 1 direction input B #define MOTOR_DRIVER_PIN_PWM1 9 // M1PWM Motor 1 speed input #define MOTOR_DRIVER_PIN_EN1DIAG1 6 // M1EN/DIAG Motor 1 enable input/fault output #define MOTOR_DRIVER_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
Powers Arduino and TXU0104
Unsure whether I can connect these: At 144 mV/A motor current, want to measure before permanently connecting, or maybe add external clamping
Female headers 2- pos: (2) Current Sense Jumper 4-pos: (1) Power test, (1) M1 Enc Test 5-Pos: (1) M1 Test, (1) M2 Test, (1) M2 Enc Test, (2) Motor Driver Board support headers, (1) 5 V buck board 13-Pos: (1) Motor Driver Board Male Headers 6-pos: (2) Motor connectors
Male headers
Arduino board is powered from 5V Buck Board
Only goes to test connector
Wires connect screw terminals
Max current: 12 A 5 minutes, 6 A indefinite Todo: Write test program to test the use of analog pins as digital IO DONE Add larger power capacitor DONE Add decoupling caps DONE Solder a 0.1 µF ceramic capacitor across the terminals of your motors DONE CHeck that there is no issue having this turned 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

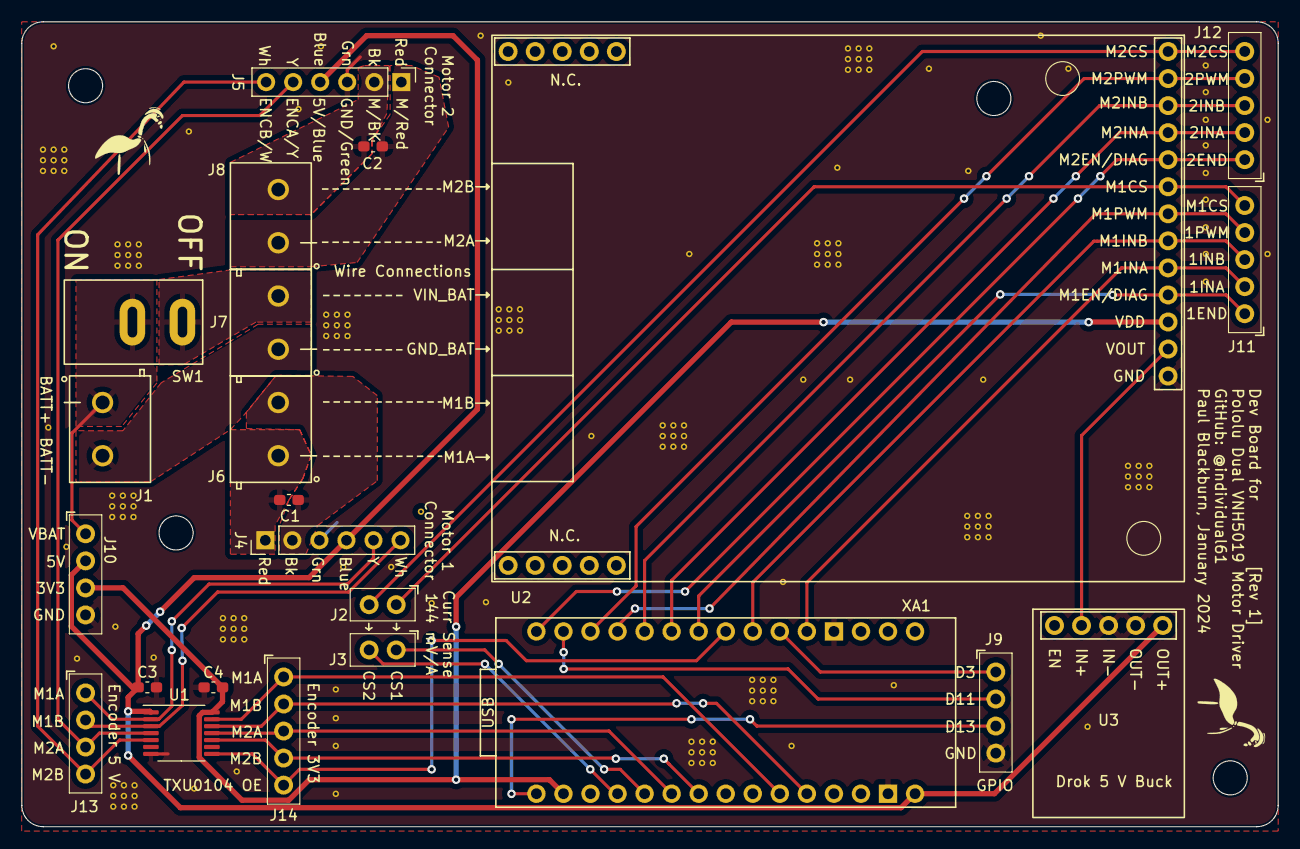
[picture p37: board r2dtf dev board rev 1.kicad_pcb from above]

Board: 2 copper layers, 118.0 x 75.6 mm, 23 parts (0 on the bottom side), 35 nets.
