individual61/r2-dtf/Mechanicals/Sources for models/Adafruit-Audio-FX-Sound-Board-PCBs-master/Adafruit-Audio-FX-Sound-Board-PCBs-master/Adafruit EZ-SFX with Amp.brd

## EAGLE design Mechanicals/Sources for models/Adafruit-Audio-FX-Sound-Board-PCBs-master/Adafruit-Audio-FX-Sound-Board-PCBs-master/Adafruit EZ-SFX with Amp.brd (2018-06-27)

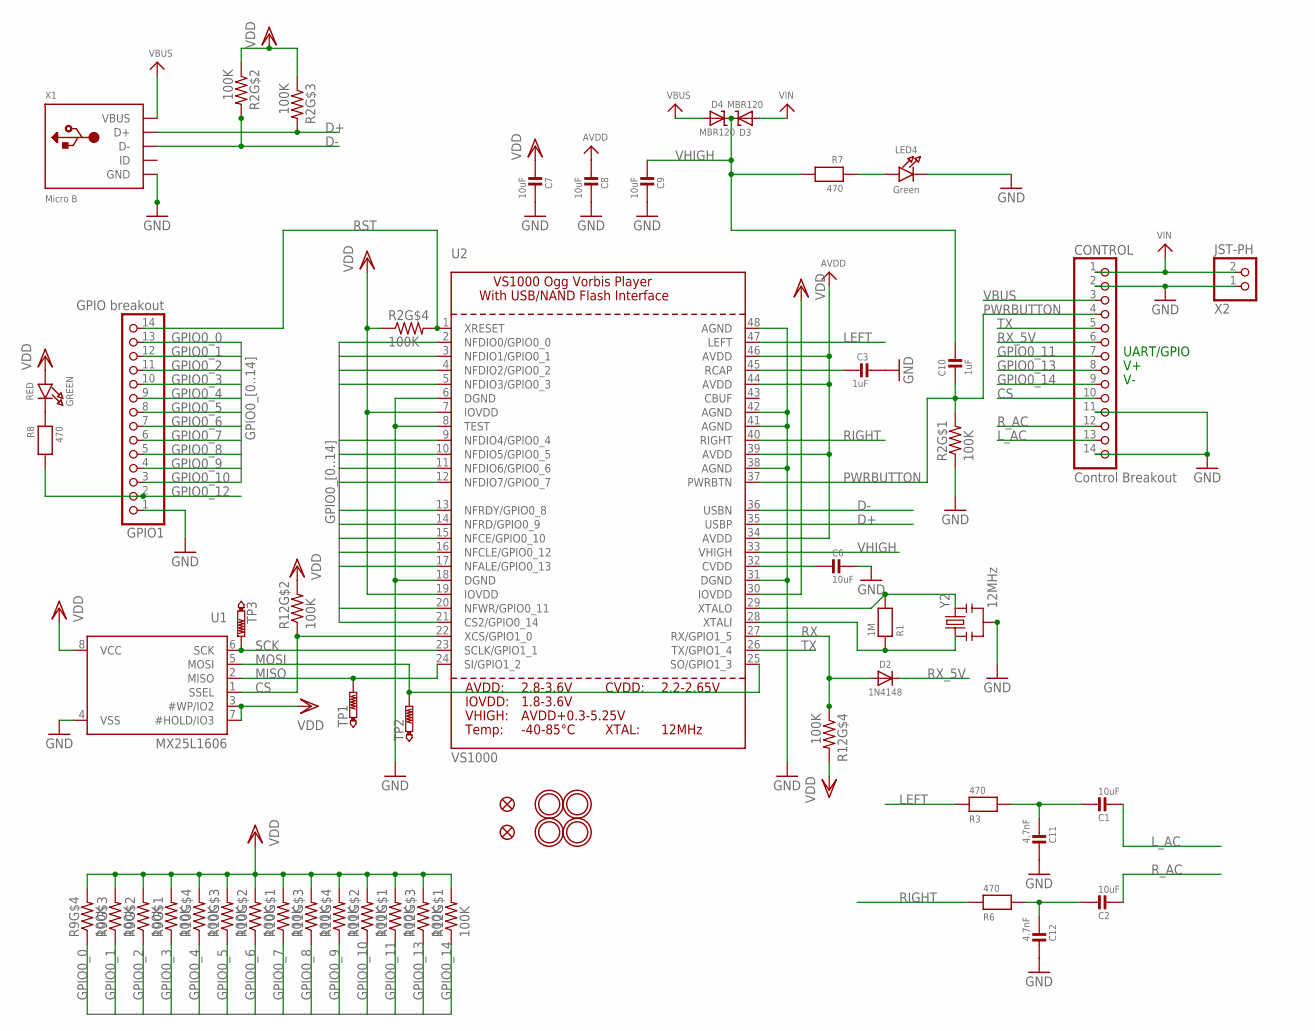
[picture p38: schematic Adafruit EZ-SFX with Amp.sch, part in row 1, column 1]

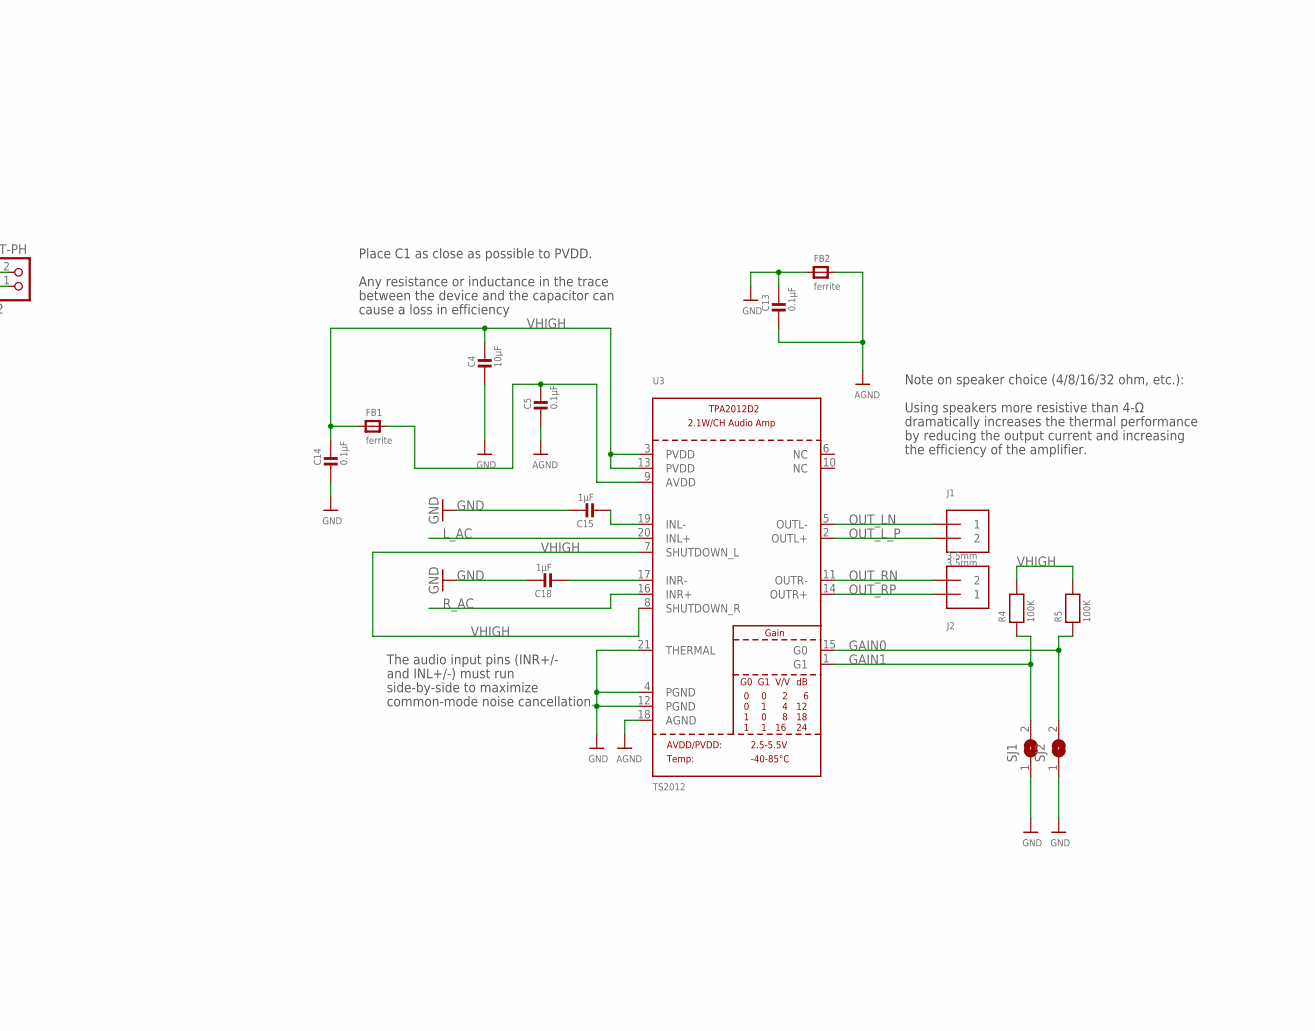
[picture p39: schematic Adafruit EZ-SFX with Amp.sch, part in row 1, column 2]

Parts:
C1, C8, C9: 10uF; 0805-NO
C2, C6, C7: 10uF; 0805_10MGAP
C3, C10: 1uF; 0805-NO
C4: 10µF; 0805-NO
C5, C13, C14: 0.1µF; 0805-NO
C11, C12: 4.7nF; 0805-NO
C15, C18: 1µF; 0805-NO
CONTROL: Control Breakout; 1X14-CB
D2: 1N4148; SOD-323
D3, D4: MBR120; SOD-123
FB1, FB2: ferrite; _0805MP
FID1, FID2: FIDUCIAL""; FIDUCIAL_1MM
GPIO1: GPIO breakout; 1X14-CB
GREEN: RED; CHIPLED_0805_NOOUTLINE
J1, J2: 3.5mm; TERMBLOCK_1X2-3.5MM
LED4: Green; CHIPLED_0805_NOOUTLINE
R1: 1M; 0805-NO
R2, R9, R10, R11, R12: 100K; RESPACK_4X0603
R3, R6, R7, R8: 470; 0805-NO
R4, R5: 100K; 0805-NO
SJ1: SOLDERJUMPER; SOLDERJUMPER_ARROW_NOPASTE
SJ2: SOLDERJUMPERCLOSED; SOLDERJUMPER_CLOSEDWIRE
TP1, TP2, TP3: PTR1B1,27; B1,27
U1: MX25L1606; SOIC8_208MIL
U2: VS1000; LQFP48
U3: TS2012; WQFN20
U$5, U$6, U$7, U$8: MOUNTINGHOLE2.5; MOUNTINGHOLE_2.5_PLATED
X1: Micro B; 4UCONN_20329
X2: JST-PH; JSTPH2
Y2: 12MHz; RESONATOR-SMD

Connections:
AGND: C5.2, C13.2, FB2.2, U3.18 (AGND)
AVDD: C8.2, U2.34 (AVDD), U2.39 (AVDD), U2.44 (AVDD), U2.46 (AVDD)
CS: CONTROL.10, R12.2 (1), U1.1 (SSEL), U2.22 (XCS/GPIO1_0)
D+: R2.6 (2), U2.35 (USBP), X1.D+
D-: R2.7 (2), U2.36 (USBN), X1.D-
GAIN0: R5.1, SJ2.2, U3.15 (G0)
GAIN1: R4.1, SJ1.2, U3.1 (G1)
GND: C3.2, C4.2, C6.1, C7.1, C8.1, C9.1, C11.2, C12.2, C13.1, C14.2, C15.1, C18.1, CONTROL.2, CONTROL.11, CONTROL.14, FB2.1, GPIO1.1, LED4.C, R2.1, SJ1.1, SJ2.1, U1.4 (VSS), U2.6 (DGND), U2.8 (TEST), U2.18 (DGND), U2.31 (DGND), U2.38 (AGND), U2.41 (AGND), U2.42 (AGND), U2.48 (AGND), U3.4 (PGND), U3.12 (PGND), U3.21 (THERMAL), X1.BASE@1 (GND), X1.BASE@2 (GND), X1.GND, X1.SPRT@1 (GND), X1.SPRT@2 (GND), X1.SPRT@3 (GND), X1.SPRT@4 (GND), X2.1, Y2.2
GPIO0_0: GPIO1.13, R9.4 (1), U2.2 (NFDIO0/GPIO0_0)
GPIO0_1: GPIO1.12, R9.3 (1), U2.3 (NFDIO1/GPIO0_1)
GPIO0_2: GPIO1.11, R9.2 (1), U2.4 (NFDIO2/GPIO0_2)
GPIO0_3: GPIO1.10, R9.1, U2.5 (NFDIO3/GPIO0_3)
GPIO0_4: GPIO1.9, R10.4 (1), U2.9 (NFDIO4/GPIO0_4)
GPIO0_5: GPIO1.8, R10.3 (1), U2.10 (NFDIO5/GPIO0_5)
GPIO0_6: GPIO1.7, R10.2 (1), U2.11 (NFDIO6/GPIO0_6)
GPIO0_7: GPIO1.6, R10.1, U2.12 (NFDIO7/GPIO0_7)
GPIO0_8: GPIO1.5, R11.3 (1), U2.13 (NFRDY/GPIO0_8)
GPIO0_9: GPIO1.4, R11.4 (1), U2.14 (NFRD/GPIO0_9)
GPIO0_10: GPIO1.3, R11.2 (1), U2.15 (NFCE/GPIO0_10)
GPIO0_11: CONTROL.7, R11.1, U2.20 (NFWR/GPIO0_11)
GPIO0_12: GPIO1.2, R8.2, U2.16 (NFCLE/GPIO0_12)
GPIO0_13: CONTROL.8, R12.3 (1), U2.17 (NFALE/GPIO0_13)
GPIO0_14: CONTROL.9, R12.1, U2.21 (CS2/GPIO0_14)
LEFT: R3.1, U2.47 (LEFT)
L_AC: C1.1, CONTROL.13, U3.20 (INL+)
MISO: TP1.TP, U1.2 (MISO), U2.24 (SI/GPIO1_2)
MOSI: TP2.TP, U1.5 (MOSI), U2.25 (SO/GPIO1_3)
unnamed: LED4.A, R7.1
unnamed: C2.2, C12.1, R6.2
unnamed: C3.1, U2.45 (RCAP)
unnamed: R1.2, U2.29 (XTALO), Y2.3
unnamed: C6.2, U2.32 (CVDD)
unnamed: C1.2, C11.1, R3.2
unnamed: C5.1, FB1.2, U3.9 (AVDD)
unnamed: GREEN.C, R8.1
unnamed: C15.2, U3.19 (INL-)
unnamed: C18.2, U3.17 (INR-)
unnamed: R1.1, U2.28 (XTALI), Y2.1
OUT_LN: J1.1, U3.5 (OUTL-)
OUT_L_P: J1.2, U3.2 (OUTL+)
OUT_RN: J2.2, U3.11 (OUTR-)
OUT_RP: J2.1, U3.14 (OUTR+)
PWRBUTTON: C10.1, CONTROL.4, R2.8 (2), U2.37 (PWRBTN)
RIGHT: R6.1, U2.40 (RIGHT)
RST: GPIO1.14, R2.5 (2), U2.1 (XRESET)
RX: D2.A, R12.4 (1), U2.27 (RX/GPIO1_5)
RX_5V: CONTROL.6, D2.C
R_AC: C2.1, CONTROL.12, U3.16 (INR+)
SCK: TP3.TP, U1.6 (SCK), U2.23 (SCLK/GPIO1_1)
TX: CONTROL.5, U2.26 (TX/GPIO1_4)
VBUS: CONTROL.3, D4.A, X1.VBUS
VDD: C7.2, GREEN.A, R2.2 (1), R2.3 (1), R2.4 (1), R9.5 (2), R9.6 (2), R9.7 (2), R9.8 (2), R10.5 (2), R10.6 (2), R10.7 (2), R10.8 (2), R11.5 (2), R11.6 (2), R11.7 (2), R11.8 (2), R12.5 (2), R12.6 (2), R12.7 (2), R12.8 (2), U1.3 (#WP/IO2), U1.7 (#HOLD/IO3), U1.8 (VCC), U2.7 (IOVDD), U2.19 (IOVDD), U2.30 (IOVDD)
VHIGH: C4.1, C9.2, C10.2, C14.1, D3.C, D4.C, FB1.1, R4.2, R5.2, R7.2, U2.33 (VHIGH), U3.3 (PVDD), U3.7 (SHUTDOWN_L), U3.8 (SHUTDOWN_R), U3.13 (PVDD)
VIN: CONTROL.1, D3.A, X2.2

Notes on the sheet:
UART/GPIO
Place C1 as close as possible to PVDD.
Any resistance or inductance in the trace
between the device and the capacitor can
cause a loss in efficiency
Using speakers more resistive than 4-Ω
dramatically increases the thermal performance
by reducing the output current and increasing
the efficiency of the amplifier.
Note on speaker choice (4/8/16/32 ohm, etc.):
The audio input pins (INR+/-
and INL+/-) must run
side-by-side to maximize
common-mode noise cancellation.

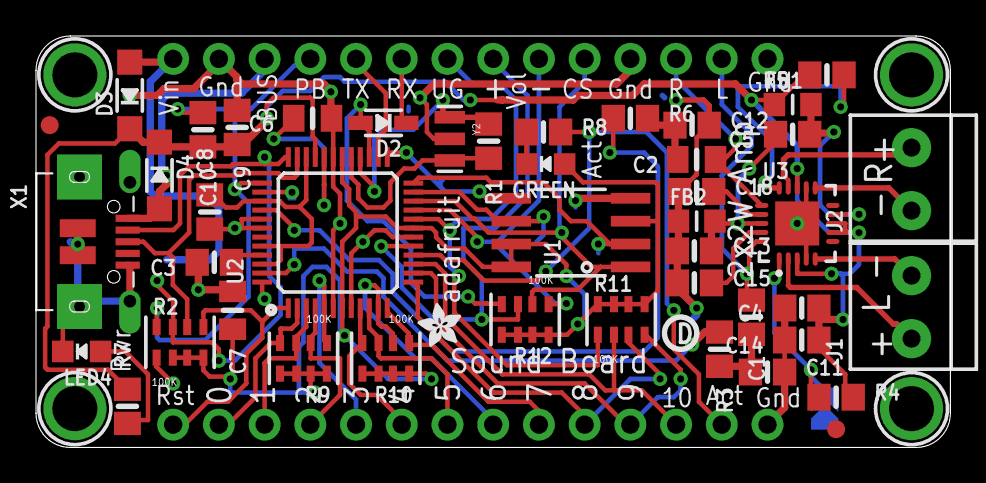
[picture p40: board Adafruit EZ-SFX with Amp.brd from above]

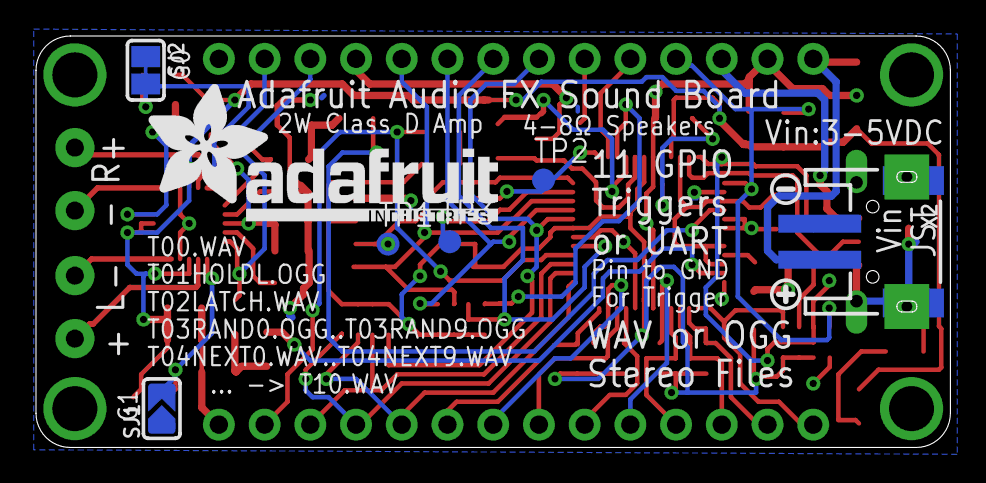
[picture p41: board Adafruit EZ-SFX with Amp.brd from below]

Board: 2 copper layers, 50.8 x 22.9 mm, 61 parts (9 on the bottom side), 54 nets.

Other parts of the board:
U$11: ADAFRUIT_2.5MM
U$12: SYMBOL_PLUS
U$13: SYMBOL_MINUS
U$14: ADAFRUIT_TEXT_20MM
U$15: PCBFEAT-REV-040
