individual61/r2-dtf/Mechanicals/Sources for models/Adafruit-Audio-FX-Sound-Board-PCBs-master/Adafruit-Audio-FX-Sound-Board-PCBs-master/Adafruit EZ-SFX Mini.brd

## EAGLE design Mechanicals/Sources for models/Adafruit-Audio-FX-Sound-Board-PCBs-master/Adafruit-Audio-FX-Sound-Board-PCBs-master/Adafruit EZ-SFX Mini.brd (2018-06-27)

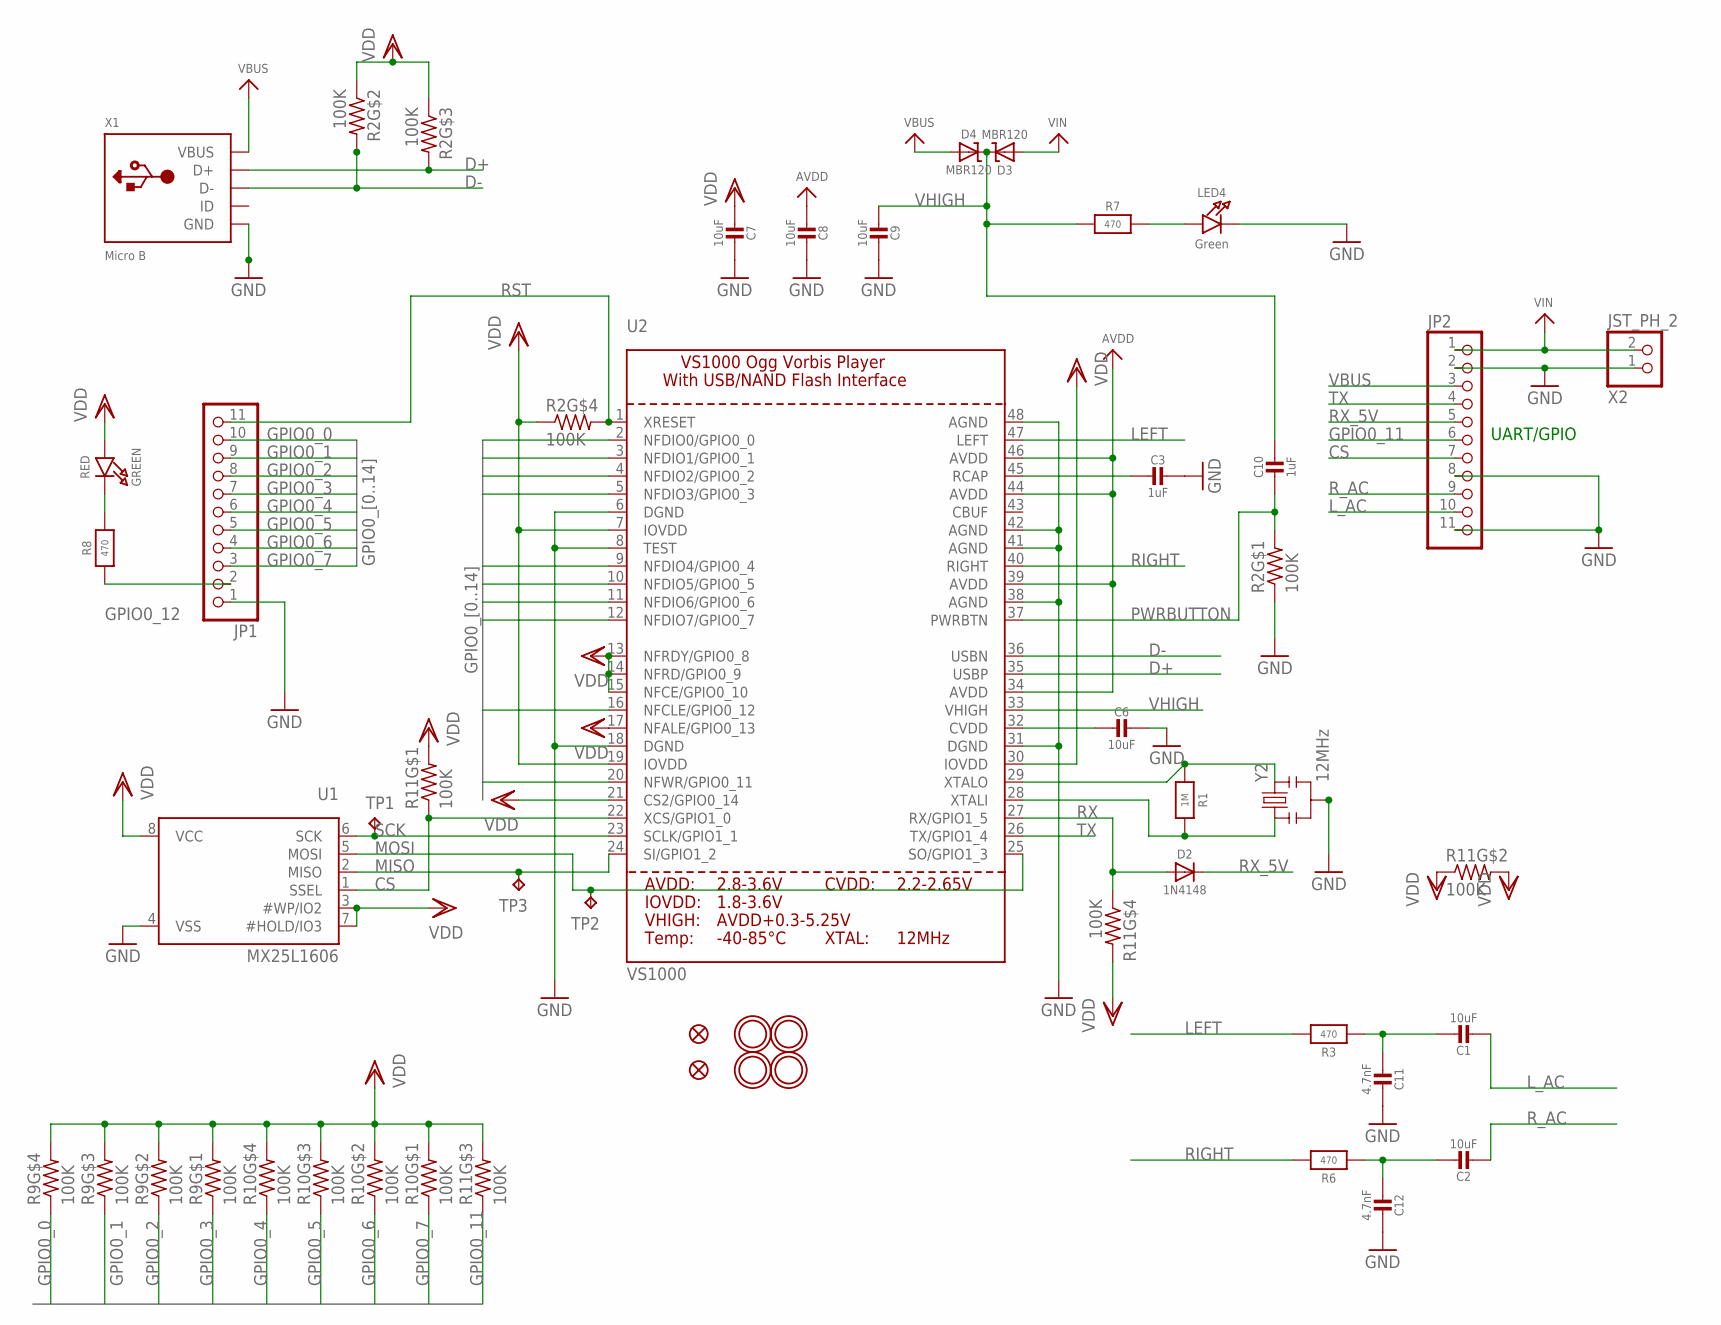
[picture p45: schematic Adafruit EZ-SFX Mini.sch]

Parts:
C1, C2, C8, C9: 10uF; 0805-NO
C3, C10: 1uF; 0805-NO
C6, C7: 10uF; 0805_10MGAP
C11, C12: 4.7nF; 0805-NO
D2: 1N4148; SOD-323
D3, D4: MBR120; SOD-123
FID1, FID2: FIDUCIAL""; FIDUCIAL_1MM
GREEN: RED; CHIPLED_0805_NOOUTLINE
JP1, JP2: HEADER-1X1176MIL; 1X11_ROUND_76
LED4: Green; CHIPLED_0805_NOOUTLINE
R1: 1M; _0805MP
R2, R9, R10, R11: 100K; RESPACK_4X0603
R3, R6, R7, R8: 470; 0805-NO
TP1, TP2, TP3: TPB1,27; B1,27
U1: MX25L1606; SOIC8_208MIL
U2: VS1000; LQFP48
U$5, U$6, U$7, U$8: MOUNTINGHOLE2.5; MOUNTINGHOLE_2.5_PLATED
X1: Micro B; 4UCONN_20329_V2
X2: JST_PH_2; JSTPH2
Y2: 12MHz; RESONATOR-SMD

Connections:
AVDD: C8.2, U2.34 (AVDD), U2.39 (AVDD), U2.44 (AVDD), U2.46 (AVDD)
CS: JP2.7, R11.1, U1.1 (SSEL), U2.22 (XCS/GPIO1_0)
D+: R2.6 (2), U2.35 (USBP), X1.D+
D-: R2.7 (2), U2.36 (USBN), X1.D-
GND: C3.2, C6.1, C7.1, C8.1, C9.1, C11.2, C12.2, JP1.1, JP2.2, JP2.8, JP2.11, LED4.C, R2.1, U1.4 (VSS), U2.6 (DGND), U2.8 (TEST), U2.18 (DGND), U2.31 (DGND), U2.38 (AGND), U2.41 (AGND), U2.42 (AGND), U2.48 (AGND), X1.BASE@1 (GND), X1.BASE@2 (GND), X1.GND, X1.SPRT@1 (GND), X1.SPRT@2 (GND), X1.SPRT@3 (GND), X1.SPRT@4 (GND), X2.1, Y2.2
GPIO0_0: JP1.10, R9.4 (1), U2.2 (NFDIO0/GPIO0_0)
GPIO0_1: JP1.9, R9.3 (1), U2.3 (NFDIO1/GPIO0_1)
GPIO0_2: JP1.8, R9.2 (1), U2.4 (NFDIO2/GPIO0_2)
GPIO0_3: JP1.7, R9.1, U2.5 (NFDIO3/GPIO0_3)
GPIO0_4: JP1.6, R10.4 (1), U2.9 (NFDIO4/GPIO0_4)
GPIO0_5: JP1.5, R10.3 (1), U2.10 (NFDIO5/GPIO0_5)
GPIO0_6: JP1.4, R10.2 (1), U2.11 (NFDIO6/GPIO0_6)
GPIO0_7: JP1.3, R10.1, U2.12 (NFDIO7/GPIO0_7)
GPIO0_11: JP2.6, R11.3 (1), U2.20 (NFWR/GPIO0_11)
GPIO0_12: JP1.2, R8.2, U2.16 (NFCLE/GPIO0_12)
LEFT: R3.1, U2.47 (LEFT)
L_AC: C1.1, JP2.10
MISO: TP3.TP, U1.2 (MISO), U2.24 (SI/GPIO1_2)
MOSI: TP2.TP, U1.5 (MOSI), U2.25 (SO/GPIO1_3)
unnamed: LED4.A, R7.1
unnamed: C2.2, C12.1, R6.2
unnamed: C3.1, U2.45 (RCAP)
unnamed: R1.2, U2.29 (XTALO), Y2.3
unnamed: C6.2, U2.32 (CVDD)
unnamed: C1.2, C11.1, R3.2
unnamed: GREEN.C, R8.1
unnamed: R1.1, U2.28 (XTALI), Y2.1
PWRBUTTON: C10.1, R2.8 (2), U2.37 (PWRBTN)
RIGHT: R6.1, U2.40 (RIGHT)
RST: JP1.11, R2.5 (2), U2.1 (XRESET)
RX: D2.A, R11.4 (1), U2.27 (RX/GPIO1_5)
RX_5V: D2.C, JP2.5
R_AC: C2.1, JP2.9
SCK: TP1.TP, U1.6 (SCK), U2.23 (SCLK/GPIO1_1)
TX: JP2.4, U2.26 (TX/GPIO1_4)
VBUS: D4.A, JP2.3, X1.VBUS
VDD: C7.2, GREEN.A, R2.2 (1), R2.3 (1), R2.4 (1), R9.5 (2), R9.6 (2), R9.7 (2), R9.8 (2), R10.5 (2), R10.6 (2), R10.7 (2), R10.8 (2), R11.2 (1), R11.5 (2), R11.6 (2), R11.7 (2), R11.8 (2), U1.3 (#WP/IO2), U1.7 (#HOLD/IO3), U1.8 (VCC), U2.7 (IOVDD), U2.13 (NFRDY/GPIO0_8), U2.14 (NFRD/GPIO0_9), U2.15 (NFCE/GPIO0_10), U2.17 (NFALE/GPIO0_13), U2.19 (IOVDD), U2.21 (CS2/GPIO0_14), U2.30 (IOVDD)
VHIGH: C9.2, C10.2, D3.C, D4.C, R7.2, U2.33 (VHIGH)
VIN: D3.A, JP2.1, X2.2

Notes on the sheet:
UART/GPIO

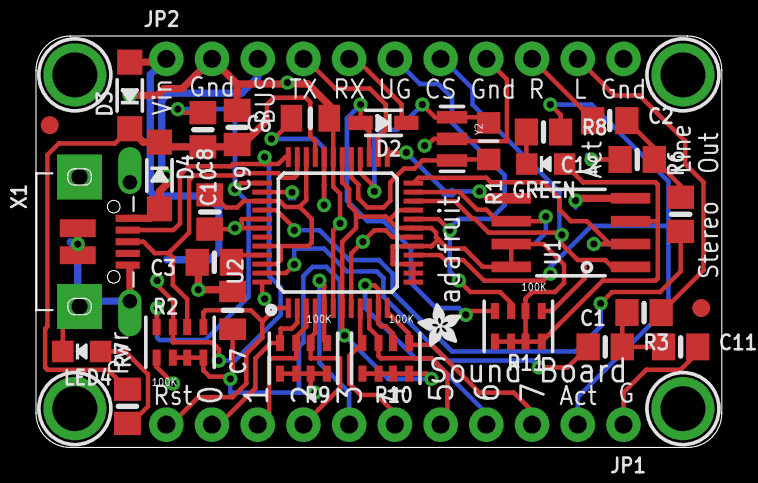
[picture p46: board Adafruit EZ-SFX Mini.brd from above]

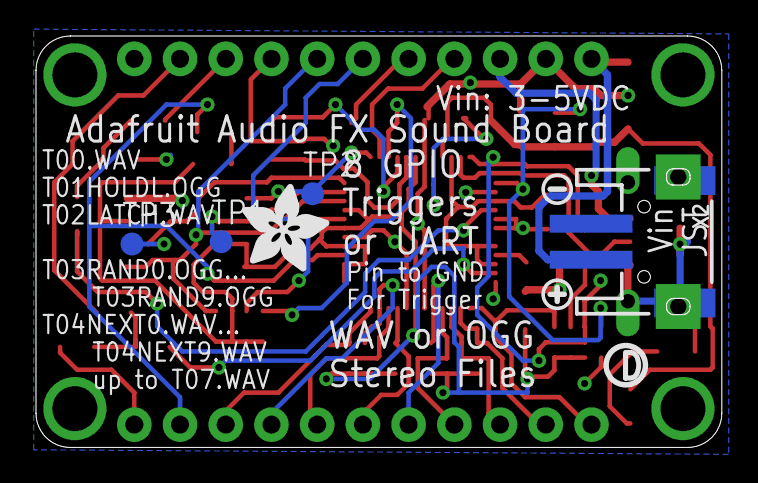
[picture p47: board Adafruit EZ-SFX Mini.brd from below]

Board: 2 copper layers, 38.1 x 22.9 mm, 45 parts (8 on the bottom side), 39 nets.

Other parts of the board:
U$11: ADAFRUIT_2.5MM
U$12: SYMBOL_PLUS
U$13: SYMBOL_MINUS
U$14: ADAFRUIT_5MM
U$15: PCBFEAT-REV-056
