individual61/r2-dtf/Calibration/IMU/SerialPlot_Calibrated values.ini

[MainWindow]
size=@Size(1885 1249)
pos=@Point(969 64)
activePanel=Log
hidePanels=false
maximized=false
state=@ByteArray(\0\0\0\xff\0\0\0\0\xfd\0\0\0\0\0\0\a]\0\0\x4\x96\0\0\0\x4\0\0\0\x4\0\0\0\b\0\0\0\b\xfc\0\0\0\x1\0\0\0\x2\0\0\0\x3\0\0\0\f\0t\0\x62\0P\0l\0o\0t\x1\0\0\0\0\xff\xff\xff\xff\0\0\0\0\0\0\0\0\0\0\0\x1a\0t\0\x62\0P\0o\0r\0t\0\x43\0o\0n\0t\0r\0o\0l\x1\0\0\0i\xff\xff\xff\xff\0\0\0\0\0\0\0\0\0\0\0\x10\0t\0\x62\0R\0\x65\0\x63\0o\0r\0\x64\x1\0\0\x1\x93\xff\xff\xff\xff\0\0\0\0\0\0\0\0)

[Port]
selectedPort=COM10
baudRate=115200
parity=none
dataBits=8
stopBits=1
flowControl=none

[DataFormat]
format=ascii

[DataFormat_Binary]
numOfChannels=2
numberFormat=uint8
endianness=little

[DataFormat_ASCII]
numOfChannels=9
delimiter=","
customDelimiter=|
filterMode=exclude
filterPrefix=#

[DataFormat_CustomFrame]
numOfChannels=1
numberFormat=uint8
endianness=little
frameStart=AA BB
fixedSize=false
frameSize=1
checksum=false
debugMode=false

[Channels]
channel\1\name=a_x
channel\1\color=@Variant(\0\0\0\x43\x1\xff\xff\xff\xff\0\0VV\0\0)
channel\1\visible=true
channel\1\gain=1
channel\1\gainEnabled=false
channel\1\offset=0
channel\1\offsetEnabled=false
channel\2\name=a_y
channel\2\color=@Variant(\0\0\0\x43\x1\xff\xff~~--\xd2\xd2\0\0)
channel\2\visible=true
channel\2\gain=1
channel\2\gainEnabled=false
channel\2\offset=0
channel\2\offsetEnabled=false
channel\3\name=a_z
channel\3\color=@Variant(\0\0\0\x43\x1\xff\xff\0\0\xae\xae~~\0\0)
channel\3\visible=true
channel\3\gain=1
channel\3\gainEnabled=false
channel\3\offset=0
channel\3\offsetEnabled=false
channel\4\name=m_x
channel\4\color=@Variant(\0\0\0\x43\x1\xff\xff\xfe\xfe\x89\x89\0\0\0\0)
channel\4\visible=true
channel\4\gain=1
channel\4\gainEnabled=false
channel\4\offset=0
channel\4\offsetEnabled=false
channel\5\name=m_y
channel\5\color=@Variant(\0\0\0\x43\x1\xff\xff\xff\xff\x93\x93~~\0\0)
channel\5\visible=true
channel\5\gain=1
channel\5\gainEnabled=false
channel\5\offset=0
channel\5\offsetEnabled=false
channel\6\name=m_z
channel\6\color=@Variant(\0\0\0\x43\x1\xff\xffjj\x82\x82ll\0\0)
channel\6\visible=true
channel\6\gain=1
channel\6\gainEnabled=false
channel\6\offset=0
channel\6\offsetEnabled=false
channel\7\name=g_x
channel\7\color=@Variant(\0\0\0\x43\x1\xff\xff\xff\xff\x2\x2\x9d\x9d\0\0)
channel\7\visible=true
channel\7\gain=1
channel\7\gainEnabled=false
channel\7\offset=0
channel\7\offsetEnabled=false
channel\8\name=g_y
channel\8\color=@Variant(\0\0\0\x43\x1\xff\xff\0\0\xb9\xb9\x17\x17\0\0)
channel\8\visible=true
channel\8\gain=1
channel\8\gainEnabled=false
channel\8\offset=0
channel\8\offsetEnabled=false
channel\9\name=g_z
channel\9\color=@Variant(\0\0\0\x43\x1\xff\xffzzGG\x82\x82\0\0)
channel\9\visible=true
channel\9\gain=1
channel\9\gainEnabled=false
channel\9\offset=0
channel\9\offsetEnabled=false
channel\size=9

[Plot]
numOfSamples=1000000
plotWidth=70000
indexAsX=true
xMax=1000
xMin=0
autoScale=true
yMax=1000
yMin=0
darkBackground=true
grid=false
minorGrid=false
legend=true
multiPlot=false
symbols=auto
numLines=1000
decimals=6

[Commands]
command\1\name=Command 1
command\1\type=ascii
command\1\data=
command\size=1

[Record]
autoIncrement=true
recordPaused=true
stopOnClose=true
header=true
disableBuffering=false
separator=","
decimals=6
timestamp=true
timestampFormat=seconds_with_precision

[UpdateCheck]
periodicCheck=true
lastCheck=2024-02-12
