individual61/r2-dtf/Code/Testing/motor-driver-2024/VNH5019 Motor Driver Test/src/leds.cpp

#include <parameters.h>
#include <function_declarations_and_globals.h>

void initialize_leds()
{
  pinMode(LED_BUILTIN, OUTPUT);
  digitalWrite(LED_BUILTIN, LOW);

  pinMode(LED_RED, OUTPUT);
  digitalWrite(LED_RED, HIGH);

  pinMode(LED_GREEN, OUTPUT);
  digitalWrite(LED_GREEN, HIGH);

  pinMode(LED_BLUE, OUTPUT);
  digitalWrite(LED_BLUE, HIGH);
}
