individual61/r2-dtf/(commit log)

2024-01-12 Initial work done on dev board and first code test
    [r2dtf dev board rev 1.kicad_pcb, r2dtf dev board rev 1.kicad_sch]
2024-01-14 Moved from library to my own motor functions, first working test of fast PWM
    [r2dtf dev board rev 1.kicad_sch]
2024-01-15 Added Test Connectors, connected Arduino, rearranged
    [r2dtf dev board rev 1.kicad_sch]
2024-01-17 Completed schematic, footprints, initial ratsnest layout of board
    [r2dtf dev board rev 1.kicad_pcb]
2024-01-19 First pass at complete Rev 1. About to quote with JLCPCB
    [r2dtf dev board rev 1.kicad_pcb, r2dtf dev board rev 1.kicad_sch]
2024-01-19 Removed thermal reliefs on high current pours
    [r2dtf dev board rev 1-B_Cu.gbl, r2dtf dev board rev 1-B_Mask.gbs, r2dtf dev board rev 1-B_Paste.gbp, r2dtf dev board rev 1-B_Silkscreen.gbo, r2dtf dev board rev 1-Edge_Cuts.gm1, r2dtf dev board rev 1-F_Cu.gtl, r2dtf dev board rev 1-F_Mask.gts, r2dtf dev board rev 1-F_Paste.gtp]
2024-01-23 Qt Gui - sucessful serial comms bidirectional
    [r2dtf dev board rev 1-B_Cu.gbl, r2dtf dev board rev 1-B_Mask.gbs, r2dtf dev board rev 1-B_Paste.gbp, r2dtf dev board rev 1-B_Silkscreen.gbo, r2dtf dev board rev 1-Edge_Cuts.gm1, r2dtf dev board rev 1-F_Cu.gtl, r2dtf dev board rev 1-F_Mask.gts, r2dtf dev board rev 1-F_Paste.gtp]
2024-01-26 Successful binary comms from arduino to Qt
2024-01-30 Most read and write of GUI done, some bits and pieces to polish
    Like brake, drive, etc.
2024-01-30 Not sure if anything changed but first successful test through to motor turning!
    [r2dtf dev board rev 1.kicad_sch]
2024-02-02 Before moving to a two-message sending method
    serial seems to choke if sending more than 128 bytes.
    [r2dtf dev board rev 1.kicad_sch]
2024-02-06 Most bugs fixed, working as intended
    Still have to implement IMU
    [dialog.cpp, dialog.h, function_declarations_and_globals.h, main.cpp, motor_driver.cpp, parameters.h, serialcomms.cpp]
2024-02-15 First successful use of an imu fusion library
    After getting total assblast from the three Adafruit_AHRS algorithms, https://github.com/xioTechnologies/Fusion finally produces something I can work with.
    [capture.csv, r2dtf dev board rev 1.kicad_sch, ra_vs_cal.csv]
2024-02-24 Beginning to make a new structure because I can't get the Fusion filter to behave and so I'm going to yolo it with PID
    [37d-gearmotor-19-30-encoder.SLDPRT, Motor-bracket-wheel.SLDASM, User Library-GY-521.SLDASM, User Library-GY-521_User Library-0603(1608M) Cap.SLDPRT, User Library-GY-521_User Library-CAP_TANT_3216-18_A_case-1.SLDPRT, User Library-GY-521_User Library-Header_Male_8Pin.sldasm, User Library-GY-521_User Library-Header_Male_8Pin_BodyArray.sldprt, User Library-GY-521_User Library-Header_Male_8Pin_PinArra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]
2024-02-27 Built and printed the Rev 1 frame
    [Bumper Rev 1.SLDPRT, Bumper Rev 1.STEP, Frame Rev 1.3mf, Frame Rev 1.SLDPRT, Frame Rev 1.STEP, Frame top Rev 1.SLDPRT, Frame top Rev 1.STEP, M3 Nut.SLDPRT]
2025-01-21 Found some changes since last commit
    [Motor-bracket-wheel.SLDASM, Test Stand Rev 1.SLDPRT, Test Stand Rev 1.STEP]
